leeyunseokarchive/VIVA-Hardware-Enabled-AI-Tutor/VivaMVP/viva-merged/docs/superpowers/plans/2026-08-10-app-split.md

# 앱 분리 (폰 단독판 / 디바이스 연동판) Implementation Plan

> **For agentic workers:** REQUIRED SUB-SKILL: Use superpowers:subagent-driven-development (recommended) or superpowers:executing-plans to implement this plan task-by-task. Steps use checkbox (`- [ ]`) syntax for tracking.

**Goal:** 하나의 앱(런타임 모드 토글)을 두 개의 스마트폰 앱 — 폰 단독 체험판 / 디바이스(라즈베리파이) 연동판 — 으로 분리한다. 한 저장소, 공용 코어 + 앱 셸 2개.

**Architecture:** 3단계. (1) 공용 코드가 디바이스 모듈을 정적 import 하는 곳을 주입으로 뒤집고 디바이스 배타 파일을 `src/device/` 로 이동. (2) `App.tsx`·`HomeScreen`·`ConversationScreen` 을 변종 2벌로 가르고 `mode` 개념 소멸, babel module-resolver alias 로 `APP_VARIANT` 별 엔트리 선택(transform 시점 그래프 절단). (3) `app.config.js` + prebuild 전환으로 빌드 갈래(이름·bundleId·권한 분기).

**Tech Stack:** Expo SDK 57 / RN 0.74 (legacy root), jest-expo + react-test-renderer, babel-plugin-module-resolver (신규 devDep 1개).

**Spec:** `docs/superpowers/specs/2026-08-10-app-split-design.md`. 스펙 대비 정정 2건 (실측 근거):
1. **EyeAnimation·MicLevelIndicator 는 `src/phone/` 으로 이동하지 않는다.** 공용 화면 4개(BoardView·CharacterView·ProcessingView·CameraScreen)가 EyeAnimation 을 정적 import 한다 — 이동하면 공용→phone 의존이 생긴다. 번들 포함은 디렉터리가 아니라 import 그래프가 결정하므로 제자리에 둬도 폰 번들 절단 목표(piBridge 부재)와 무관하다. 대가: 디바이스 번들에 EyeAnimation 죽은 코드 ~수백 줄이 남는다(렌더 경로 없음, `showEyes=false` 상수). 진짜 제거하려면 공용 화면 4개에 눈 컴포넌트 주입이 필요 — 범위 밖.
2. **"공용 코드에 src/device import 0건" 판정은 1단계가 아니라 2단계 종료 시점.** 1단계에서는 App.tsx·HomeScreen·ConversationScreen 이 아직 안 갈라져 디바이스 모듈을 import 한다.

## Global Constraints

- **워크트리 격리 필수.** 메인 체크아웃엔 병렬 세션의 미커밋 `src/screens/HomeScreen.tsx` 변경("헤이, 비바" 문구)이 있다. `git worktree add <path> HEAD` 로 만든 워크트리에서 작업한다 (origin/main 은 로컬보다 25커밋 뒤 — 기본 fresh 워크트리 금지). **`git add -A` 금지, 항상 파일 명시 add.**
- 병합 시점 주의: 이 계획은 구 `HomeScreen.tsx` 를 삭제한다. 병렬 세션이 그 파일의 문구 변경을 커밋하면 병합 충돌 — 해소는 "문구 변경을 `src/device/screens/HomeScreen.tsx` 변종에 재적용"이다.
- bundleId: 디바이스 = `com.vivamvp.app` (기존 유지, 실기기 설치본), 폰 = `com.vivamvp.phone`.
- `APP_VARIANT` 미지정 기본값 = `device` (현행 워크플로·실기기와 동일하게).
- 테스트: `npm test` (jest-expo). 타입: `npx tsc --noEmit`. 린트: `npm run lint`.
- 커밋 접두는 저장소 관례(`feat:`/`fix:`/`refactor:`/`docs:`/`test:`), 한국어 제목. 트레일러: `Co-Authored-By: Claude Fable 5 <noreply@anthropic.com>`.
- 세션 페이로드·기록 포맷(`photoSource` 필드 포함) 불변.
- 마지막에 `docs/process.md` 갱신 (AGENTS.md 규칙).

## 파일 구조 (완료 시점)

```
viva-merged/
  App.phone.tsx            폰 셸 (Task 7)
  App.device.tsx           디바이스 셸 (Task 7)
  index.js                 import App from '@app' (babel alias, Task 7)
  babel.config.js          APP_VARIANT → alias 분기 (Task 7)
  app.config.js            app.json 대체 (Task 9)
  src/
    device/                Task 4에서 이동 + Task 6에서 변종 화면 추가
      services/  piBridge, connectionMonitor, eyeSync, piWakeStream (+ __tests__)
      hooks/     usePiConnection (+ __tests__)
      components/ DeviceVitals, ConnectionGuideCard, ConnectionStatusChip,
                  DisconnectOverlay (+ __tests__)
      screens/   HomeScreen.tsx, ConversationScreen.tsx (+ __tests__)
    phone/
      screens/   HomeScreen.tsx, ConversationScreen.tsx (+ __tests__)
    components/ hooks/ services/ screens/ …  공용 (EyeAnimation·MicLevelIndicator 포함)
  (삭제: App.tsx, src/screens/HomeScreen.tsx, src/screens/ConversationScreen.tsx,
   src/components/ModeToggle.tsx, src/hooks/useAppMode.ts, app.json,
   android/, ios/ (Task 10 gate 통과 시))
```

---

## 1단계: 의존성 뒤집기 + 배타 파일 이동

### Task 1: useAppState — eyeSync 직접 호출을 콜백 주입으로

**Files:**
- Modify: `src/hooks/useAppState.ts`
- Modify: `src/services/eyeSync.service.ts` (STATUS_EYE_STATE 이사)
- Modify: `App.tsx:87-95` (콜백 배선)
- Test: `src/hooks/__tests__/useAppState.test.ts`

**Interfaces:**
- Consumes: 없음 (첫 태스크)
- Produces: `useAppState(options?: { onStatusChange?: (status: AppStatus) => void })` — 시그니처 하위호환(옵션 없이 호출 가능). `eyeSync.service.ts` 가 `export const STATUS_EYE_STATE: Record<AppStatus, EyeState>` 를 새로 export. Task 7 의 App.device.tsx 가 이 둘을 조합해 배선한다.

- [ ] **Step 1: 실패하는 테스트 추가**

`src/hooks/__tests__/useAppState.test.ts` 에 추가 (기존 테스트가 eyeSync 를 mock 하고 있으면 그 mock 은 제거 — 이 태스크가 의존 자체를 없앤다):

```ts
it('전이마다 onStatusChange 콜백을 새 status 로 부른다', () => {
  const onStatusChange = jest.fn();
  const { result } = renderHook(() => useAppState({ onStatusChange }));
  act(() => result.current.startCapturing());
  expect(onStatusChange).toHaveBeenLastCalledWith('capturing');
  act(() => result.current.resetToIdle());
  expect(onStatusChange).toHaveBeenLastCalledWith('idle');
});

it('옵션 없이 호출해도 전이가 동작한다 (폰 셸 경로)', () => {
  const { result } = renderHook(() => useAppState());
  act(() => result.current.startProcessing());
  expect(result.current.appState.status).toBe('processing');
});
```

- [ ] **Step 2: 실패 확인** — `npm test -- useAppState` → FAIL (options 파라미터 없음)

- [ ] **Step 3: 구현**

`src/hooks/useAppState.ts`:
- `import { eyeSyncService } ...` 와 `import type { EyeState } ...`, `STATUS_EYE_STATE` 상수(19-26행) 삭제. 상수와 그 주석 블록(11-18행)은 eyeSync.service.ts 로 그대로 이사.
- 시그니처·콜백:

```ts
export interface UseAppStateOptions {
  /** 상태 전이마다 새 status 로 호출된다. 디바이스 셸이 Pi 눈 미러링
   * (eyeSyncService.sendEyeState(STATUS_EYE_STATE[status]))을 등록한다.
   * 폰 셸은 안 넘긴다 - 미러링 대상이 없다. */
  onStatusChange?: (status: AppStatus) => void;
}

export function useAppState(options?: UseAppStateOptions): UseAppStateResult {
  const [appState, setAppState] = useState<AppState>(initialAppState);
  const previousStatusRef = useRef<AppStatus>(initialAppState.status);
  // 렌더마다 갱신 - transitionTo([]) 가 stale 콜백을 부르지 않게.
  const onStatusChangeRef = useRef(options?.onStatusChange);
  onStatusChangeRef.current = options?.onStatusChange;

  const transitionTo = useCallback((next: AppState) => {
    setAppState(() => {
      console.log(`[AppState] ${previousStatusRef.current} -> ${next.status}`);
      previousStatusRef.current = next.status;
      onStatusChangeRef.current?.(next.status);
      return next;
    });
  }, []);
  // ... 이하 동일
```

`src/services/eyeSync.service.ts` 에 추가:

```ts
import type { AppStatus } from '../types/AppState';
// (STATUS_EYE_STATE 주석 블록을 useAppState.ts 에서 그대로 가져온다)
export const STATUS_EYE_STATE: Record<AppStatus, EyeState> = {
  idle: 'idle',
  capturing: 'idle',
  processing: 'listening',
  conversation: 'conversation',
  history: 'idle',
  session_detail: 'idle',
};
```

`App.tsx` AppContent 시작부(87행):

```ts
import { CALLING_HOLD_MS, eyeSyncService, STATUS_EYE_STATE } from './src/services/eyeSync.service';
// ...
const {
  appState, startCapturing, startProcessing, enterConversation,
  resetToIdle, enterHistory, viewSessionDetail,
} = useAppState({
  onStatusChange: useCallback(
    (status) => eyeSyncService.sendEyeState(STATUS_EYE_STATE[status]),
    [],
  ),
});
```

- [ ] **Step 4: 통과 확인** — `npm test -- useAppState` PASS, 이어서 `npm test` 전체 + `npx tsc --noEmit`. `grep -n "eyeSync" src/hooks/useAppState.ts` → 0건.

- [ ] **Step 5: 커밋** — `git add src/hooks/useAppState.ts src/services/eyeSync.service.ts App.tsx src/hooks/__tests__/useAppState.test.ts` → `refactor: useAppState 의 눈 미러링을 콜백 주입으로 뒤집기`

### Task 2: tts.service — robotSpeaker 플래그를 AudioSink 주입으로

**Files:**
- Modify: `src/services/tts.service.ts`
- Modify: `src/screens/ConversationScreen.tsx:28,108-111` (setRobotSpeaker → setAudioSink)
- Test: `src/services/__tests__/tts.service.test.ts` (robot 케이스 전환)

**Interfaces:**
- Produces:

```ts
export interface AudioSink {
  /** base64 mp3 재생. 재생 완료(또는 중단)까지 resolve 보류. throw 하면
   * speak() 이 폰 스피커로 폴백한다 - 폴백을 원치 않는 셸은 sink 안에서
   * 삼키고 resolve 한다 (디바이스 연동판 정책). */
  play: (base64Mp3: string) => Promise<void>;
  stop: () => Promise<void>;
}
export function setAudioSink(sink: AudioSink | null): void;
```

`setRobotSpeaker` 는 삭제 (호출부는 ConversationScreen 한 곳 + 테스트).

- [ ] **Step 1: 실패하는 테스트** — `tts.service.test.ts` 의 `setRobotSpeaker` 케이스(83-91행 부근)를 다음으로 교체:

```ts
it('AudioSink 가 등록되면 폰 재생 대신 sink.play 로 간다', async () => {
  const play = jest.fn().mockResolvedValue(undefined);
  setAudioSink({ play, stop: jest.fn().mockResolvedValue(undefined) });
  await speak('안녕');
  expect(play).toHaveBeenCalledTimes(1);
  // 폰 경로(파일 쓰기/Sound 로드)는 안 탄다 - 기존 robot 케이스의 단언 유지
  setAudioSink(null);
});

it('sink.play 가 throw 하면 폰 스피커로 폴백한다', async () => {
  setAudioSink({ play: jest.fn().mockRejectedValue(new Error('pi down')), stop: jest.fn() });
  await speak('안녕');
  // 기존 "robotSpeaker 폴백" 케이스의 폰 재생 단언을 그대로 재사용
  setAudioSink(null);
});

it('stopSpeaking 은 등록된 sink.stop 을 부른다', async () => {
  const stop = jest.fn().mockResolvedValue(undefined);
  setAudioSink({ play: jest.fn().mockResolvedValue(undefined), stop });
  await stopSpeaking();
  expect(stop).toHaveBeenCalled();
  setAudioSink(null);
});
```

(기존 robot 테스트의 mock 구조를 최대한 재사용 — 단언 대상만 piBridge mock → sink spy 로 바뀐다. `jest.mock('.../piBridge.service')` 가 tts 테스트에 있으면 제거.)

- [ ] **Step 2: 실패 확인** — `npm test -- tts.service` → FAIL (`setAudioSink` 없음)

- [ ] **Step 3: 구현** — `tts.service.ts`:
- 24행 `import { playAudioOnPi, stopPiPlayback } from './piBridge.service';` 삭제.
- 66-74행 (`robotSpeaker` 변수 + `setRobotSpeaker`) 을 위 Interfaces 의 `AudioSink`/`setAudioSink` 로 교체 (`let audioSink: AudioSink | null = null;`). 기존 로봇 스피커 라우팅 주석은 sink 용어로 고쳐 유지.
- `stopSpeaking()` (246-251행): `if (robotSpeaker) { stopPiPlayback().catch(...) }` → `if (audioSink) { audioSink.stop().catch(() => {}); }`
- `speak()` (310-324행): `if (robotSpeaker)` → `if (audioSink)`, `await playAudioOnPi(base64Mp3)` → `await audioSink.play(base64Mp3)`. 폴백 catch 로직·onPlay(0)·주석 유지.

`ConversationScreen.tsx`:
- 28행 import: `setRobotSpeaker` → `setAudioSink`, type `AudioSink` 추가.
- 108-111행:

```ts
useEffect(() => {
  setAudioSink(robotMode ? { play: playAudioOnPi, stop: stopPiPlayback } : null);
  return () => setAudioSink(null);
}, [robotMode]);
```

(`playAudioOnPi`, `stopPiPlayback` 는 이미 이 파일이 piBridge 에서 import 중 — `playAudioOnPi` 만 import 목록에 추가.)

- [ ] **Step 4: 통과 확인** — `npm test` 전체 + `npx tsc --noEmit`. `grep -n "piBridge" src/services/tts.service.ts` → 0건.

- [ ] **Step 5: 커밋** — `refactor: tts 로봇 스피커 플래그를 AudioSink 주입으로 뒤집기`

### Task 3: useVoiceInput — robotMic 불리언을 RobotMicAdapter 주입으로

**Files:**
- Modify: `src/hooks/useVoiceInput.ts`
- Modify: `src/screens/ConversationScreen.tsx:317-330` (adapter 전달)
- Test: `src/hooks/__tests__/useVoiceInput.test.ts` (robotMic 케이스 전환)

**Interfaces:**
- Produces:

```ts
export interface RobotMicStatus {
  recording: boolean;
  silent_ms?: number;
  had_speech: boolean;
}
export interface RobotMicAdapter {
  /** 녹음 시작. throw 시 폰 마이크 폴백 여부는 allowPhoneMicFallback 이 결정. */
  startRecording: () => Promise<void>;
  stopRecording: () => Promise<void>;
  fetchStatus: () => Promise<RobotMicStatus>;
  /** 발화 전체 WAV base64. */
  fetchAudio: () => Promise<string>;
}
```

옵션 변경: `robotMic?: boolean` → `robotMic?: RobotMicAdapter | null`. 신규 옵션 `allowPhoneMicFallback?: boolean` (기본 `true`; `false` 면 로봇 마이크 시작 실패 시 폰 마이크 대신 `text_fallback` — 디바이스 연동판의 "음성 폰 폴백 없음" 정책, Task 6 이 사용).

- [ ] **Step 1: 실패하는 테스트** — `useVoiceInput.test.ts` 의 robotMic 케이스(73-96행 부근의 mock 포함)를 어댑터 주입으로 전환. piBridge `jest.mock` 을 제거하고:

```ts
const makeAdapter = (overrides = {}) => ({
  startRecording: jest.fn().mockResolvedValue(undefined),
  stopRecording: jest.fn().mockResolvedValue(undefined),
  fetchStatus: jest.fn().mockResolvedValue({ recording: true, silent_ms: 0, had_speech: false }),
  fetchAudio: jest.fn().mockResolvedValue('d2F2'),
  ...overrides,
});

it('로봇 어댑터가 있으면 폰 스트림 대신 어댑터로 녹음을 시작한다', async () => {
  const adapter = makeAdapter();
  const { result } = renderHook(() =>
    useVoiceInput({ onResult: jest.fn(), robotMic: adapter, audioStreamModule: fakeStream }));
  await act(() => result.current.startListening());
  expect(adapter.startRecording).toHaveBeenCalled();
  expect(fakeStream.start).not.toHaveBeenCalled();
});

it('어댑터 시작 실패 + allowPhoneMicFallback:false 면 text_fallback 으로 간다', async () => {
  const adapter = makeAdapter({ startRecording: jest.fn().mockRejectedValue(new Error('EBUSY')) });
  const { result } = renderHook(() =>
    useVoiceInput({ onResult: jest.fn(), robotMic: adapter, allowPhoneMicFallback: false,
      audioStreamModule: fakeStream }));
  await act(() => result.current.startListening());
  expect(result.current.mode).toBe('text_fallback');
  expect(fakeStream.start).not.toHaveBeenCalled();
});

it('어댑터 시작 실패 + 기본값이면 폰 마이크로 폴백한다', async () => {
  const adapter = makeAdapter({ startRecording: jest.fn().mockRejectedValue(new Error('EBUSY')) });
  // 기존 "Pi 시작 실패 → 폰 폴백" 케이스의 단언 재사용 (fakeStream.start 호출됨)
});
```

기존 robot 폴링/종료 테스트(status 폴링 → finalize → fetchAudio → 전사)는 mock 대상만 어댑터 spy 로 바꿔 유지한다.

- [ ] **Step 2: 실패 확인** — `npm test -- useVoiceInput` → FAIL

- [ ] **Step 3: 구현** — `useVoiceInput.ts`:
- 31-36행 piBridge import 삭제, Interfaces 의 타입 2개 추가.
- 옵션: `robotMic = null`, `allowPhoneMicFallback = true`. `robotMicRef` 는 어댑터를 든다: `const robotMicRef = useRef(robotMic); robotMicRef.current = robotMic;`
- `startRobotListening`: `await startPiRecording()` → `await adapter.startRecording()` (어댑터는 호출 시점 `robotMicRef.current`), 폴링 루프의 `fetchPiRecordStatus()` → `adapter.fetchStatus()`.
- `finalizeRobotResult`: `fetchPiAudioBase64()` → `adapter.fetchAudio()`.
- 언마운트 effect(383-386행)·`stopListening`(521-524행): `if (robotMicRef.current) { stopPiRecording().catch(...) }` → `robotMicRef.current?.stopRecording().catch(() => {});`
- `startListening`(407-410행):

```ts
if (robotMicRef.current) {
  const robotStarted = await startRobotListening();
  if (robotStarted) return;
  if (!allowPhoneMicFallback) {
    // 디바이스 연동판: 마이크는 파이 전용 - 폰 마이크로 조용히 잇지 않는다.
    setMode('text_fallback');
    return;
  }
}
```

(`allowPhoneMicFallback` 도 ref 미러 — 다른 옵션과 같은 패턴.)

`ConversationScreen.tsx` 317-330행:

```ts
const robotMicAdapter = useMemo<RobotMicAdapter | null>(
  () =>
    robotMode
      ? {
          startRecording: startPiRecording,
          stopRecording: stopPiRecording,
          fetchStatus: fetchPiRecordStatus,
          fetchAudio: fetchPiAudioBase64,
        }
      : null,
  [robotMode],
);
const voice = useVoiceInput({
  onResult: handleVoiceResult,
  robotMic: robotMicAdapter,
  getTranscribeContext: ...,  // 기존 그대로
});
```

(`fetchPiRecordStatus` 의 반환 타입이 `RobotMicStatus` 와 구조적으로 맞는지 확인 — 안 맞으면 어댑터 안에서 매핑.)

- [ ] **Step 4: 통과 확인** — `npm test` 전체 + `npx tsc --noEmit`. `grep -n "piBridge" src/hooks/useVoiceInput.ts` → 0건.

- [ ] **Step 5: 커밋** — `refactor: useVoiceInput 로봇 마이크를 어댑터 주입으로 뒤집기`

### Task 4: 디바이스 배타 파일 `src/device/` 이동 + PiWakeStream 포트 타입 이사

**Files:**
- Move (`git mv`, 테스트 동반):
  - `src/services/{piBridge,connectionMonitor,eyeSync,piWakeStream}.service.ts` → `src/device/services/`
  - `src/services/__tests__/{piBridge.health,connectionMonitor.service,eyeSync.service,eyeSync.suppress,piWakeStream.service}.test.ts` → `src/device/services/__tests__/`
  - `src/hooks/usePiConnection.ts` → `src/device/hooks/`, `src/hooks/__tests__/usePiConnection.test.ts` → `src/device/hooks/__tests__/`
  - `src/components/{DeviceVitals,ConnectionGuideCard,ConnectionStatusChip,DisconnectOverlay}.tsx` → `src/device/components/`, 대응 `__tests__` 4개 동반
- Modify: `src/hooks/useWakeWord.ts` (PiWakeStream 인터페이스를 여기로 이사 — 포트는 소비자가 정의), `src/device/services/piWakeStream.service.ts` (타입 import 방향 반전), 이동 파일들의 상대 경로, importer 경로: `App.tsx`, `src/screens/HomeScreen.tsx`, `src/screens/ConversationScreen.tsx`, `src/components/ModeToggle.tsx`(연기 — useAppMode 타입만 쓰므로 무변경), `tools/e2e-loop/runner.e2e.ts`, `tools/e2e-loop/driveSession.ts`

**Interfaces:**
- Consumes: Task 1-3 의 주입 전환 (이동 대상들이 더 이상 공용 코드에서 역참조되지 않는 상태… 화면·App 제외)
- Produces: `useWakeWord.ts` 가 `export interface PiWakeStream` 의 새 소유자. 기존 시그니처 그대로 옮기고, `piWakeStream.service.ts`·`App.tsx` 는 `import type { PiWakeStream } from '../../hooks/useWakeWord'`(각자 상대 경로) 로 바꾼다. 그 외 모든 모듈의 export 시그니처 불변 — 경로만 바뀐다.

- [ ] **Step 1: git mv 로 이동** — 위 목록 그대로. 예: `git mv src/services/piBridge.service.ts src/device/services/piBridge.service.ts`
- [ ] **Step 2: 이동 파일 내부의 상대 경로 수정** — 같이 이동한 모듈끼리는 상대 경로 불변(`./piBridge.service`, `../services/connectionMonitor.service` 등 디렉터리 구조가 평행이라 그대로 맞다). 공용을 가리키던 것만 한 단계 추가: eyeSync 의 `../components/EyeAnimation` → `../../components/EyeAnimation`, `../types/AppState` → `../../types/AppState`, DisconnectOverlay·칩 등의 `../theme` → `../../theme` 류. 테스트 파일의 mock 경로(`jest.mock('../../services/...')`)도 같이.
- [ ] **Step 3: PiWakeStream 포트 이사** — `piWakeStream.service.ts` 의 `PiWakeStream`(+ 콜백 타입) 인터페이스 선언을 `src/hooks/useWakeWord.ts` 로 옮기고 export. piWakeStream.service 는 `import type { PiWakeStream } from '../../hooks/useWakeWord';` 로 구현 선언 유지. `App.tsx:32` 의 타입 import 도 `./src/hooks/useWakeWord` 로.
- [ ] **Step 4: importer 경로 갱신** — `App.tsx`(piBridge·connectionMonitor·piWakeStream·eyeSync·usePiConnection → `./src/device/...`), `src/screens/ConversationScreen.tsx`·`src/screens/HomeScreen.tsx`(`../device/...`), `tools/e2e-loop/runner.e2e.ts`·`driveSession.ts`(`../../src/device/services/piBridge.service`).
- [ ] **Step 5: 전체 검증** — `npx tsc --noEmit` → 잔여 경로 오류 0. `npm test` 전체 PASS. `npm run lint` PASS.
- [ ] **Step 6: 커밋** — 이동·수정 파일 명시 add → `refactor: 디바이스 배타 모듈을 src/device/ 로 이동`

---

## 2단계: 셸 가르기

### Task 5: 폰 화면 변종 (`src/phone/screens/`)

**Files:**
- Create: `src/phone/screens/HomeScreen.tsx`, `src/phone/screens/ConversationScreen.tsx`
- Test: `src/phone/screens/__tests__/HomeScreen.test.tsx`, `src/phone/screens/__tests__/ConversationScreen.test.tsx`

**Interfaces:**
- Produces (Task 7 의 App.phone.tsx 가 소비):

```ts
// src/phone/screens/HomeScreen.tsx
interface HomeScreenProps {
  onPressToTalk: () => void;
  onPressHistory: () => void;
  solveMode: boolean;
  onToggleSolveMode: () => void;
}
// src/phone/screens/ConversationScreen.tsx
interface ConversationScreenProps {
  conversation?: ConversationPayload;
  onSessionComplete?: () => void;
  onCameraNeeded?: (question?: string, resume?: ResumeSessionSnapshot) => void;
  solveMode: boolean;
  onToggleSolveMode: () => void;
}
```

- [ ] **Step 1: HomeScreen 변종 작성** — `src/screens/HomeScreen.tsx` 기반, 소멸: `mode`/`onToggleMode`/`piStatus` props, ModeToggle·ConnectionStatusChip·ConnectionGuideCard import 와 렌더, `deviceMode`/`startDisabled` (PTT 는 항상 활성). 중앙은 눈 하나만:

```tsx
<View style={styles.centerArea}>
  <View testID="home-eyes">
    <EyeAnimation state="idle" />
  </View>
</View>
```

경로 주의: `src/phone/screens/` 기준 `../../components/...`, `../../theme`, `../../assets/icons/mic.png`.

- [ ] **Step 2: HomeScreen 테스트** — `src/phone/screens/__tests__/HomeScreen.test.tsx` 신규: 눈 렌더(`home-eyes`), PTT 활성 + onPressToTalk 호출, history 버튼. 구 `src/screens/__tests__/HomeScreen.test.tsx` 의 단언을 이식하되 mode 관련 단언은 버린다.
- [ ] **Step 3: ConversationScreen 변종 작성** — `src/screens/ConversationScreen.tsx` 복사 후 순서대로:
  1. import 삭제: piBridge 전체(30-37행), `DisconnectOverlay`, `AppMode` 타입, `usePiConnection`, `eyeSyncService`.
  2. props: `robotAudio`/`appMode`/`onSwitchToAppMode` 삭제 (위 Interfaces).
  3. `robotMode`(107행)·`setAudioSink` effect(108-111행) 삭제.
  4. `piStatus`/`disconnected`/`disconnectedRef`(113-117행) 삭제. `customSpeak` 의 `if (disconnectedRef.current) return;` 삭제. 끊김 일시정지 effect(336-347행) 삭제. 자동 재청취 가드의 `!disconnected` 조건과 deps 삭제.
  5. `useVoiceInput` 호출에서 `robotMic` 어댑터 삭제 (Task 3 이후의 `robotMicAdapter` useMemo 통째로).
  6. 눈 미러링 effect(622-624행, `eyeSyncService.sendEyeState(eyeState)`) 삭제 — 폰 눈은 `CharacterView state={eyeState}` prop 으로 이미 간다.
  7. `showEyes={appMode === 'app'}` → `showEyes` (BoardView 800행·CharacterView 809행, `showEyes={true}` 의미).
  8. 자막 게이트 919행 `statusSlot.kind === 'subtitle' && !(appMode === 'device' && !requiresBoard)` → `statusSlot.kind === 'subtitle'`.
  9. DisconnectOverlay 블록(951-956행) 삭제.
- [ ] **Step 4: ConversationScreen 테스트** — 구 `src/screens/__tests__/ConversationScreen.test.tsx` 를 복사해 `src/phone/screens/__tests__/` 로. 디바이스 조건부 케이스(`robotAudio`/`appMode="device"`/`disconnected`/`setRobotSpeaker` — 75-150행 부근)를 삭제하고 음성/텍스트 폴백/자막 케이스만 유지, import 경로 갱신.
- [ ] **Step 5: 검증** — `npm test -- phone` PASS + `npx tsc --noEmit`. (구 화면·테스트는 Task 8 까지 공존 — 전체 스위트도 그대로 초록이어야 한다.)
- [ ] **Step 6: 커밋** — `feat: 폰 단독판 화면 변종 (HomeScreen·ConversationScreen)`

### Task 6: 디바이스 화면 변종 + DeviceVitals 배선 + 탈출구 제거

**Files:**
- Create: `src/device/screens/HomeScreen.tsx`, `src/device/screens/ConversationScreen.tsx`
- Modify: `src/device/components/DisconnectOverlay.tsx` (+ 그 테스트) — "휴대폰으로 계속하기" 제거
- Test: `src/device/screens/__tests__/HomeScreen.test.tsx`, `src/device/screens/__tests__/ConversationScreen.test.tsx`

**Interfaces:**
- Consumes: `usePiDeviceHealth(): PiHealth | null` (`src/device/hooks/usePiConnection.ts`), `DeviceVitals` props `{ status: PiConnectionStatus; health: PiHealth | null }`, Task 3 의 `RobotMicAdapter`·`allowPhoneMicFallback`, Task 2 의 `AudioSink`.
- Produces (Task 7 의 App.device.tsx 가 소비):

```ts
// src/device/screens/HomeScreen.tsx
interface HomeScreenProps {
  piStatus: PiConnectionStatus;
  onPressToTalk: () => void;
  onPressHistory: () => void;
  solveMode: boolean;
  onToggleSolveMode: () => void;
}
export const MIC_GRACE_MS = 12000;
export function graceHealth(health: PiHealth | null, connectedSinceMs: number | null, nowMs: number): PiHealth | null;
// src/device/screens/ConversationScreen.tsx — props 는 폰 변종 + robotAudio?: boolean
// DisconnectOverlay — props 가 { onEndSession: () => void } 로 축소
```

- [ ] **Step 1: graceHealth 실패 테스트 먼저** — `src/device/screens/__tests__/HomeScreen.test.tsx`:

```ts
import { graceHealth, MIC_GRACE_MS } from '../HomeScreen';

describe('graceHealth (F1: 연결 엣지 mic_ok 오탐 디바운스)', () => {
  it('연결 직후 grace 안의 micOk:false 는 undefined 로 강등한다', () => {
    const g = graceHealth({ micOk: false, speakerOk: true }, 1000, 1000 + MIC_GRACE_MS - 1);
    expect(g).toEqual({ micOk: undefined, speakerOk: true });
  });
  it('grace 가 지나면 micOk:false 를 그대로 통과시킨다', () => {
    const g = graceHealth({ micOk: false, speakerOk: true }, 1000, 1000 + MIC_GRACE_MS);
    expect(g).toEqual({ micOk: false, speakerOk: true });
  });
  it('micOk:true·null health·미연결(connectedSince null)은 손대지 않는다', () => {
    expect(graceHealth({ micOk: true }, 1000, 1001)).toEqual({ micOk: true });
    expect(graceHealth(null, 1000, 1001)).toBeNull();
    expect(graceHealth({ micOk: false }, null, 1001)).toEqual({ micOk: false });
  });
});
```

- [ ] **Step 2: 실패 확인** → **Step 3: HomeScreen 변종 구현** — 구 HomeScreen 기반. 소멸: `mode`/`onToggleMode`, ModeToggle, EyeAnimation 분기(APP 모드 중앙). 유지: ConnectionStatusChip, 웨이크 가이드/연결 중/가이드 카드 3분기, PTT(`piStatus !== 'connected'` 면 disabled), history, SolveModeToggle. 추가:

```tsx
// F1 (device-vitals 스펙 정정 절): 연결 직후 첫 /health 프로브는 wake 스트림
// resume 전이라 멀쩡한 마이크도 mic_ok:false 로 온다. 연결 엣지에서
// MIC_GRACE_MS 동안 micOk:false 를 "모름"으로 강등해 오탐 주황 점을 막는다.
// 5초 폴링이라 grace 만료 후 늦어도 다음 폴에서 실값이 반영된다.
export const MIC_GRACE_MS = 12000;
export function graceHealth(
  health: PiHealth | null, connectedSinceMs: number | null, nowMs: number,
): PiHealth | null {
  if (!health || health.micOk !== false || connectedSinceMs === null) return health;
  if (nowMs - connectedSinceMs < MIC_GRACE_MS) return { ...health, micOk: undefined };
  return health;
}
```

컴포넌트 안:

```tsx
const health = usePiDeviceHealth();
// state 여야 한다 (ref 금지): 엣지 직후 grace 적용된 값으로 재렌더가 일어나야
// 한다 - ref 면 다음 5초 폴 재렌더까지 주황 점이 그대로 보인다.
const [connectedSince, setConnectedSince] = useState<number | null>(null);
useEffect(() => {
  setConnectedSince(piStatus === 'connected' ? Date.now() : null);
}, [piStatus]);
// ...
<ConnectionStatusChip status={piStatus} safeTop={safeTop} />
<DeviceVitals status={piStatus} health={graceHealth(health, connectedSince, Date.now())} />
```

(DeviceVitals 배치는 칩 줄 나란히 — DeviceVitals 자체 스타일이 이미 그 문법. 칩의 safeTop 오프셋은 ModeToggle 소멸로 `safeTop` 으로 당긴다.)

- [ ] **Step 4: HomeScreen 렌더 테스트** — connected + health `{micOk:true, speakerOk:true}` mock 시 `device-vitals` testID 렌더, disconnected 시 ConnectionGuideCard·PTT disabled. (usePiConnection/usePiDeviceHealth 는 `jest.mock`.)
- [ ] **Step 5: DisconnectOverlay 축소** — `onContinueInAppMode` prop·버튼 제거, "세션 종료"만 유지. 테스트에서 해당 버튼 케이스 삭제.
- [ ] **Step 6: ConversationScreen 변종** — 복사 후:
  1. props: `appMode`/`onSwitchToAppMode` 삭제, `robotAudio` 유지.
  2. `disconnected = piStatus === 'disconnected'` (appMode 조건 삭제).
  3. AudioSink 를 무폴백 sink 로 (스펙 "음성 폰 폴백 없음"):

```ts
useEffect(() => {
  setAudioSink(
    robotMode
      ? {
          // 디바이스 연동판: 스피커는 파이 전용. 재생 실패 시 폰 스피커로
          // 이어가지 않는다 - 삼키고 resolve 하면 speak() 은 폴백 없이 끝나고
          // 자막(onPlay(0) 경로)이 내용을 전달한다.
          play: async (b64) => {
            try { await playAudioOnPi(b64); } catch (err) {
              console.warn('[ConversationScreen] Pi playback failed - staying silent:', err);
            }
          },
          stop: stopPiPlayback,
        }
      : null,
  );
  return () => setAudioSink(null);
}, [robotMode]);
```

  4. `useVoiceInput` 에 `allowPhoneMicFallback: false` 추가 (robotMic 어댑터 유지).
  5. `showEyes={appMode === 'app'}` → `showEyes={false}` (2곳).
  6. 자막 게이트 919행 → `statusSlot.kind === 'subtitle' && requiresBoard`.
  7. DisconnectOverlay 호출부에서 `onContinueInAppMode` 삭제.
- [ ] **Step 7: ConversationScreen 테스트** — 구 테스트의 디바이스 케이스를 복사·이식(끊김 시 오버레이·마이크 정지, robotAudio sink 등록). 신규 단언: 오버레이에 "휴대폰으로 계속" 부재, sink 등록 시 무폴백(play reject 후 폰 재생 mock 미호출).
- [ ] **Step 8: 검증** — `npm test` 전체 PASS + `npx tsc --noEmit`.
- [ ] **Step 9: 커밋** — `feat: 디바이스 연동판 화면 변종 + DeviceVitals 배선(F1 grace) + 앱모드 탈출구 제거`

### Task 7: 앱 셸 2벌 + APP_VARIANT 엔트리 선택

**Files:**
- Create: `App.phone.tsx`, `App.device.tsx`
- Modify: `babel.config.js`, `index.js`, `package.json` (devDep + scripts)

**Interfaces:**
- Consumes: Task 1 `useAppState(options)`, Task 4 의 `src/device/` 경로·`PiWakeStream`(useWakeWord 소유), Task 5·6 화면 변종 props.
- Produces: `@app` alias — `APP_VARIANT=phone` 이면 `./App.phone`, 그 외 `./App.device`.

- [ ] **Step 1: devDep 설치** — `npm i -D babel-plugin-module-resolver`
- [ ] **Step 2: babel.config.js**

```js
module.exports = function (api) {
  // APP_VARIANT 별로 캐시를 가른다 - 안 가르면 변형 전환 후에도 이전 alias 로
  // 변환된 캐시가 남는다. 전환 시 번들러 재시작(-c) 필요한 건 동일.
  api.cache.using(() => process.env.APP_VARIANT);
  const variant = process.env.APP_VARIANT === 'phone' ? 'phone' : 'device';
  return {
    presets: ['babel-preset-expo'],
    plugins: [
      ['module-resolver', { alias: { '@app': `./App.${variant}` } }],
      // 반드시 마지막 (Reanimated 공식 문서 요구사항).
      'react-native-reanimated/plugin',
    ],
  };
};
```

- [ ] **Step 3: App.device.tsx** — 현 `App.tsx` 에서 출발, 소멸 목록:
  - `useAppMode`/`mode`/`setMode`/`toggleMode`/`modeRef` 전부. `useAppState` 는 Task 1 의 콜백 배선 유지.
  - 모드 effect(151-162행) → 마운트 effect 로:

```ts
useEffect(() => {
  connectionMonitor.start();
  return () => connectionMonitor.stop();
}, []);
```

  (`eyeSyncService.setSuppressed` 호출 자체 불필요 — 억제 개념은 APP 모드 전용이었다. `stopPiPlayback`/`stopPiRecording` 정리 분기도 모드 전환이 없으니 소멸.)
  - `wakePiSource`(166-177행): 가드가 연결만 본다 — `if (connectionMonitor.status !== 'connected') throw ...`
  - `beginCapture`: `const usePi = connectionMonitor.status === 'connected';` (안전값 폰 카메라 폴백 경로·pi 실패 catch 의 probeNow 분기 전부 유지 — "촬영만 폰 폴백").
  - 웨이크 effect(338-370행): `mode === 'device'` 분기만 남긴다 (idle 아니면 정지, connected 면 resume→startListening, 아니면 stopListening). `mode` dep 삭제.
  - 렌더: `HomeScreen`(device 변종 — `piStatus`+`onPressToTalk`+`onPressHistory`+solve props), `CameraScreen showEyes={false}`, `ProcessingView showEyes={false}`, `ConversationScreen`(device 변종 — `robotAudio={piStatus === 'connected'}`, appMode/onSwitchToAppMode 없음).
  - import 는 `./src/device/...` 변종 화면·서비스로.
- [ ] **Step 4: App.phone.tsx** — 현 `App.tsx` 에서 출발, 소멸: piWakeStream/connectionMonitor/eyeSync/piBridge/usePiConnection import 전부, `wakePiSource`, 모드 effect, beginCapture 의 pi 경로(`eyeSyncService.sendEyeState('calling')` 포함 — 폰은 미러 대상 없음) → 골자:

```ts
const beginCapture = useCallback(async () => {
  console.log('[App] beginCapture (phone)');
  if (stopListeningRef.current) {
    try { await stopListeningRef.current(); } catch (err) {
      console.warn('[App] wake word teardown failed - continuing to capture:', err);
    }
  }
  resumeSessionRef.current = undefined;
  // 마이크 스트림 해제 대기 (기존 openPhoneCamera 주석·700ms 유지)
  await new Promise<void>((resolve) => setTimeout(resolve, 700));
  startCapturing();
}, [startCapturing]);
const { startListening, stopListening } = useWakeWord(beginCapture);
```

  웨이크 effect 는 `appState.status !== 'idle' ? stopListening() : startListening()` 두 갈래만. `useAppState()` 는 옵션 없이. 렌더: phone 변종 화면들, `showEyes={true}` (CameraScreen·ProcessingView).
  (`useWakeWord` 의 opts 파라미터가 필수면 `useWakeWord(beginCapture, {})` — 구현 확인 후 맞춘다.)
- [ ] **Step 5: index.js** — `import App from './App';` → `import App from '@app';`
- [ ] **Step 6: package.json scripts** — 기존 4개에 APP_VARIANT 명시:

```json
"start": "APP_VARIANT=device expo start",
"start:phone": "APP_VARIANT=phone expo start",
"android": "APP_VARIANT=device expo run:android",
"android:phone": "APP_VARIANT=phone expo run:android",
"ios": "APP_VARIANT=device expo run:ios",
"ios:phone": "APP_VARIANT=phone expo run:ios",
```

- [ ] **Step 7: 검증** — `npx tsc --noEmit` (App.phone/App.device 포함), `npm test` 전체. jest 는 babel.config 를 타므로 alias 존재가 무해한지 확인(테스트는 `@app` 을 import 하지 않는다).
- [ ] **Step 8: 커밋** — `feat: 폰/디바이스 앱 셸 분리 + APP_VARIANT 엔트리 선택`

### Task 8: 구 단일 앱 소멸 + 경계 고정 + 번들 검증

**Files:**
- Delete: `App.tsx`, `src/screens/HomeScreen.tsx`, `src/screens/ConversationScreen.tsx`, `src/components/ModeToggle.tsx`, `src/hooks/useAppMode.ts`
- Delete tests: `src/hooks/__tests__/useAppMode.test.ts`, `src/components/__tests__/HomeScreen.modes.test.tsx`, `src/screens/__tests__/HomeScreen.test.tsx`, `src/screens/__tests__/ConversationScreen.test.tsx`
- Modify: `src/components/__tests__/connectionUi.test.tsx` (ModeToggle describe 블록 삭제, import 경로는 Task 4 에서 이미 device 로), `.eslintrc.js`

**Interfaces:**
- Consumes: Task 5-7 완료 (변종·셸이 구 파일의 유일한 대체재)

- [ ] **Step 1: 참조 잔존 확인** — `grep -rn "screens/HomeScreen\|screens/ConversationScreen\|ModeToggle\|useAppMode" src/ App.*.tsx index.js tools/ --include="*.ts*" | grep -v "phone/screens\|device/screens"` → 삭제 대상 자신들 외 0건이어야 진행.
- [ ] **Step 2: `git rm` 으로 삭제** (위 목록), connectionUi.test 의 ModeToggle 블록 삭제.
- [ ] **Step 3: 경계 고정** — `.eslintrc.js`:

```js
rules: {
  'prettier/prettier': 'warn',
  // 공용·폰 코드가 디바이스 그래프를 물면 폰 번들 절단이 무너진다.
  'no-restricted-imports': ['error', { patterns: [
    { group: ['**/device/**'], message: '디바이스 모듈은 src/device/ 와 App.device.tsx 만 import 할 수 있다.' },
  ]}],
},
overrides: [
  {
    files: ['src/device/**', 'App.device.tsx', 'tools/e2e-loop/**'],
    rules: {
      'no-restricted-imports': ['error', { patterns: [
        { group: ['**/phone/**'], message: '디바이스 그래프는 폰 변종을 import 할 수 없다.' },
      ]}],
    },
  },
  {
    files: ['src/phone/**', 'App.phone.tsx'],
    rules: {
      'no-restricted-imports': ['error', { patterns: [
        { group: ['**/device/**'], message: '폰 그래프는 디바이스 모듈을 import 할 수 없다.' },
      ]}],
    },
  },
],
```

  (기존 `.eslintrc.js` 구조에 맞춰 병합. `npm run lint` 로 실효 확인 — 일부러 위반 import 를 임시로 넣어 에러가 나는지 1회 확인 후 되돌린다.)
- [ ] **Step 4: 전체 검증** — `npm test` PASS, `npx tsc --noEmit`, `npm run lint`.
- [ ] **Step 5: 번들 절단 실증** —

```bash
APP_VARIANT=phone npx expo export --platform android --output-dir /tmp/phone-export
grep -rc "piBridge\|connectionMonitor" /tmp/phone-export/_expo/static/js | sort  # 전부 :0 기대
APP_VARIANT=device npx expo export --platform android --output-dir /tmp/device-export
grep -rlc "piBridge" /tmp/device-export/_expo/static/js  # ≥1 기대 (대조군)
```

  (export 출력 디렉터리 구조가 다르면 js 번들 파일을 찾아 같은 grep. 실패 시 원인 보고 — 넘어가지 않는다.)
- [ ] **Step 6: 커밋** — `refactor: 단일 앱 셸·모드 토글 소멸, 변종 경계 eslint 고정`

---

## 3단계: 빌드 갈래

### Task 9: app.config.js 전환

**Files:**
- Create: `app.config.js`
- Delete: `app.json`

**Interfaces:**
- Consumes: Task 7 의 `APP_VARIANT` 관례.
- Produces: variant 별 `{ name, slug, bundleId/package, 권한 }`. 디바이스 = 현 app.json 과 동일 값 유지.

- [ ] **Step 1: app.config.js 작성** — 현 `app.json`(위 값 그대로) 을 기반으로:

```js
// APP_VARIANT=phone|device (기본 device - 기존 워크플로 유지).
// 폰 단독판은 Pi 로컬넷 관련 권한·예외가 전부 빠진다: NSLocalNetworkUsageDescription,
// NSBonjourServices, viva.local ATS 예외, android usesCleartextTraffic.
const phone = process.env.APP_VARIANT === 'phone';

module.exports = {
  expo: {
    name: phone ? 'VIVA 체험판' : 'VIVA',
    slug: phone ? 'viva-phone' : 'viva-merged',
    version: '1.0.0',
    orientation: 'landscape',
    icon: './assets/icon.png',
    userInterfaceStyle: 'light',
    ios: {
      supportsTablet: true,
      bundleIdentifier: phone ? 'com.vivamvp.phone' : 'com.vivamvp.app',
      ...(phone
        ? {}
        : {
            infoPlist: {
              NSLocalNetworkUsageDescription:
                'VIVA가 로봇 헤드(라즈베리파이)와 같은 와이파이에서 통신하기 위해 로컬 네트워크 접근이 필요합니다.',
              NSBonjourServices: ['_http._tcp'],
              NSAppTransportSecurity: {
                NSExceptionDomains: {
                  'viva.local': {
                    NSExceptionAllowsInsecureHTTPLoads: true,
                    NSIncludesSubdomains: true,
                  },
                },
              },
            },
          }),
    },
    android: {
      package: phone ? 'com.vivamvp.phone' : 'com.vivamvp.app',
      ...(phone ? {} : { usesCleartextTraffic: true }),
      adaptiveIcon: {
        backgroundColor: '#FAF7F0',
        foregroundImage: './assets/android-icon-foreground.png',
        backgroundImage: './assets/android-icon-background.png',
        monochromeImage: './assets/android-icon-monochrome.png',
      },
    },
    web: { favicon: './assets/favicon.png' },
    plugins: [
      ['@react-native-voice/voice', { microphonePermission: 'Allow VIVA to access your microphone for voice tutoring.' }],
      ['react-native-vision-camera', { cameraPermissionText: 'Allow VIVA to access your camera to scan math problems.', enableMicrophonePermission: false }],
      'expo-dev-client',
      ['expo-splash-screen', { image: './assets/splash-icon.png', imageWidth: 200, resizeMode: 'contain', backgroundColor: '#FAF7F0' }],
    ],
  },
};
```

  (앱 이름 'VIVA 체험판' 은 잠정 — 사용자 확정 대상으로 보고에 명시.)
- [ ] **Step 2: app.json 삭제** — `git rm app.json`. `npx expo config --json | head -40` 과 `APP_VARIANT=phone npx expo config --json | head -40` 으로 두 변형의 name/bundleId/권한 분기 확인.
- [ ] **Step 3: 커밋** — `feat: app.config.js 로 전환 - APP_VARIANT 별 이름·bundleId·권한 분기`

### Task 10: prebuild 전환 (게이트 있음)

**Files:**
- Inspect: `android/`, `ios/` (커밋본 vs 재생성본 diff)
- Delete (게이트 통과 시): `android/`, `ios/` + `.gitignore` 에 두 줄 추가

- [ ] **Step 1: 재생성 diff** — 워크트리에서 (모두 커밋된 상태 확인 후):

```bash
npx expo prebuild --platform all --no-install
git status --short   # android/ ios/ 변경 목록
git diff --stat android ios
git diff android ios > /tmp/prebuild.diff   # 검토용
```

- [ ] **Step 2: 게이트 판정** — diff 를 읽고 분류: (a) config·플러그인이 재생성하는 정상 차이(버전 코드, 자동 생성 주석 등) 뿐이면 통과. (b) **수동 네이티브 수정 발견 시 중단** — 해당 수정을 목록화해 보고하고, config plugin 이관은 별도 결정. `patches/` 3개는 node_modules 패치라 무관.
- [ ] **Step 3: (통과 시) 네이티브 삭제** — `git checkout -- android ios && git rm -r android ios`, `.gitignore` 에 `/android`·`/ios` 추가. `npx expo prebuild --platform android` 재실행으로 클린 생성 확인 (빌드까지는 실기기 단계 — 사람 몫으로 기록).
- [ ] **Step 4: 커밋** — `feat: prebuild(CNG) 전환 - 커밋된 네이티브 프로젝트 제거`
- [ ] **Step 5: docs/process.md 갱신** — 앱 분리 완료 기록 (진행 히스토리 + 현재 상태 + 사람 몫: 실기기에서 `npm run android` / `npm run android:phone` 각각 설치·스모크(웨이크→촬영→대화 한 턴), 폰 변형은 로컬넷 권한 프롬프트 부재 확인). 커밋 `docs: 앱 분리 진행 기록`

---

## 테스트 요약 (스펙 대비)

- 소멸: `useAppMode.test.ts`, `HomeScreen.modes.test.tsx`, `connectionUi.test.tsx` ModeToggle 블록, 구 화면 테스트 2개 (Task 8).
- 분리: ConversationScreen 테스트 → 변종별 (Task 5·6). robot 케이스 → 주입 계약 테스트 (Task 2·3).
- 신규: `graceHealth` (F1), DisconnectOverlay 축소, 무폴백 sink/mic, eslint 경계, 번들 grep (Task 6·8).
- 알려진 기존 실패: 메인 체크아웃의 `HomeScreen.modes.test.tsx` 1건은 병렬 세션 미커밋 변경 탓 — 워크트리(HEAD)에선 초록이며, Task 8 에서 파일 자체가 소멸한다.

## 위험

- 병렬 세션 충돌: Global Constraints 참조. 병합 시 구 HomeScreen 삭제 vs 문구 변경 충돌 예상 — 문구를 device 변종에 이식해 해소.
- 셸 가르기 회귀: 변종별 실기기 스모크는 사람 몫 (Task 10 Step 5 에 기록).
- prebuild: Task 10 게이트가 안전판. 게이트 (b) 면 중단하고 보고.

---

## 추가 요구 (2026-08-10 사용자 지시, 실행 중 접수)

### Task 9 수정: 아이콘 분기
폰판 = 기존 로고 유지, 디바이스판 = 로봇 눈 idle 로고 (`assets/icon-device.png` 및
`android-icon-device-{foreground,background,monochrome}.png`, 92c50aa 생성 —
`tools/gen_device_icon.py` 로 재생성 가능). app.config.js 에서 `icon`·`adaptiveIcon` 을
variant 로 분기한다.

### Task 11: DeviceVitals — 상시 표시 → 이상 시에만 배지

**Files:** Modify `src/device/components/DeviceVitals.tsx` (+ 테스트),
`src/device/services/piBridge.service.ts`·`connectionMonitor.service.ts` (`PiHealth` 에
`camOk?`·`displayOk?` 수용), `src/device/screens/HomeScreen.tsx` (배선 불변 확인)

- 표시 규칙: 부품별로 `false` 일 때만 이상 배지 렌더 (마이크 안 들려 / 소리가 안 나와 /
  카메라 안 보여 / 화면이 안 나와). `true`·`undefined` 는 아무것도 안 그린다 —
  connected + 전부 정상이면 컴포넌트가 null (기존 "모름은 비표시" 원칙의 확장).
- 배지 문법: 기존 점+라벨 디자인 유지하되 주황 점 + INK 라벨 (정상 초록 점 소멸).
- `PiHealth` 에 `camOk?: boolean; displayOk?: boolean` 추가 — `optionalBool` 파싱 재사용.
  파이 서버가 아직 안 보내므로 undefined → 미표시 (하위호환).
- 접근성: 이상 있을 때만 컨테이너 accessibilityLabel "비바 상태: 마이크 안 들려" 식으로.
- **파이 서버 카메라·디스플레이 프로브는 범위 밖** — 후속 (실기기 배포 필요).
- graceHealth(F1)는 micOk 강등 로직 그대로 유효.
