leeyunseokarchive/VIVA-Hardware-Enabled-AI-Tutor/VivaMVP/viva-merged/tools/concept-images/img/counting-cases.png

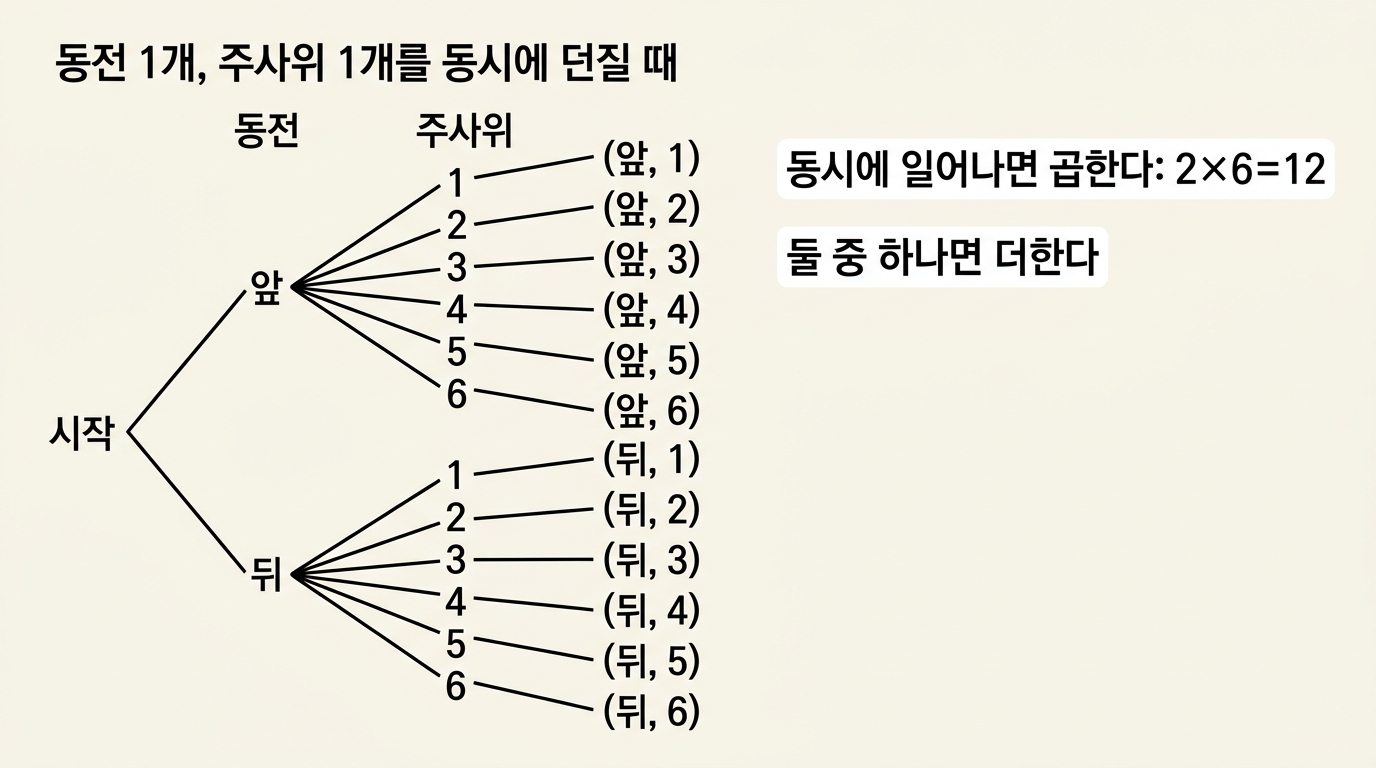
VivaMVP/viva-merged/tools/concept-images/img/counting-cases.png
