leeyunseokarchive/VIVA-Hardware-Enabled-AI-Tutor/VivaMVP/viva-merged/tools/concept-images/img/factorization.png

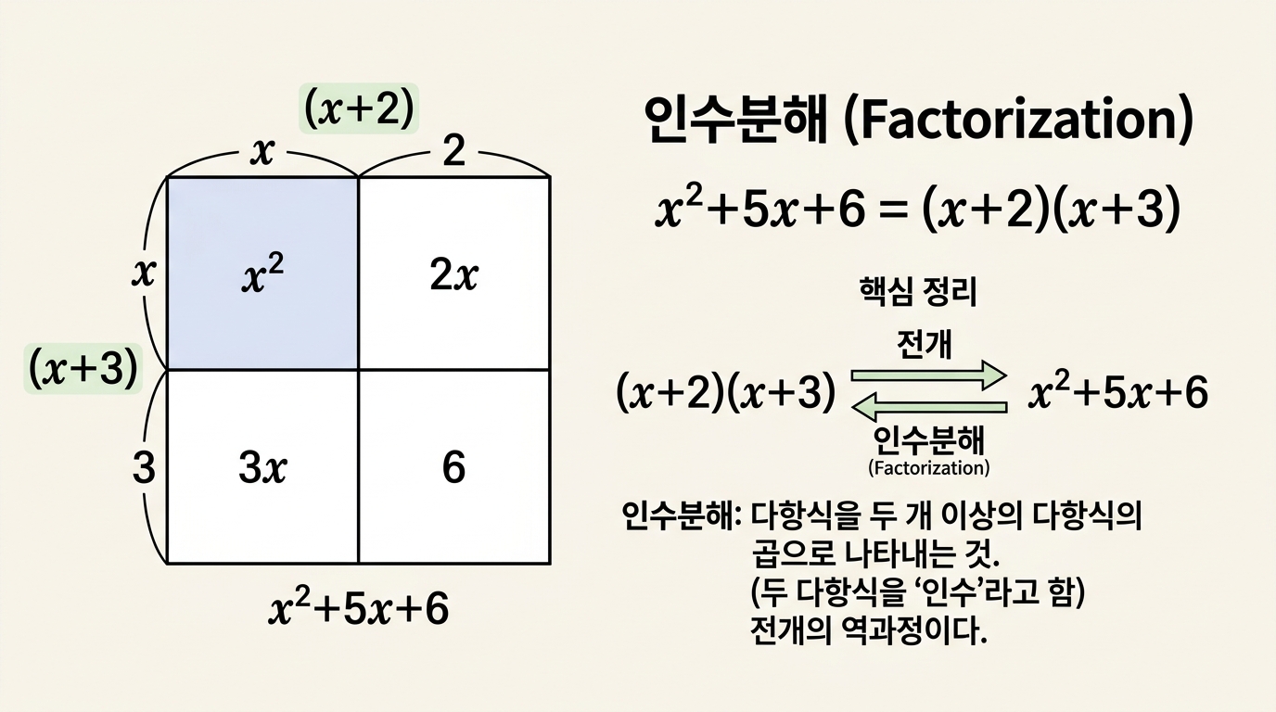
VivaMVP/viva-merged/tools/concept-images/img/factorization.png
