leeyunseokarchive/VIVA-Hardware-Enabled-AI-Tutor/VivaMVP/viva-merged/tools/concept-images/img/function-concept.png

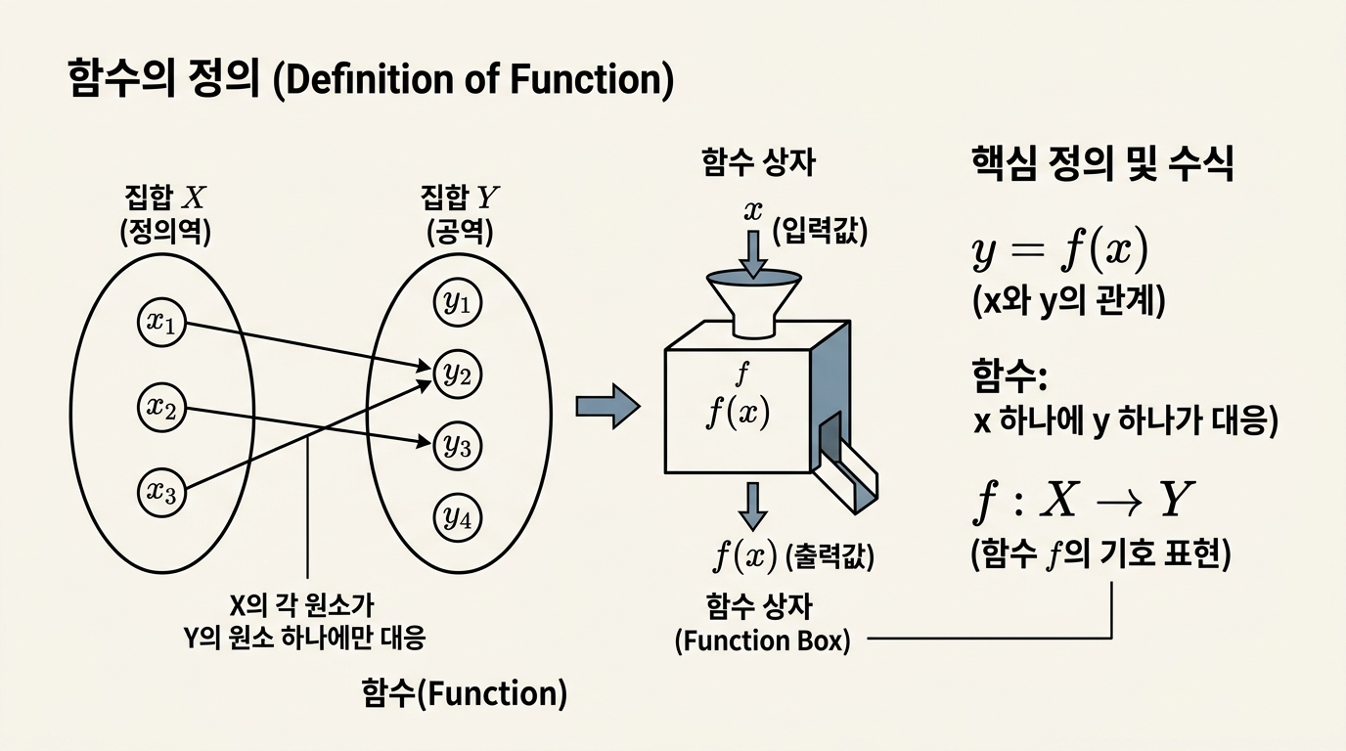
VivaMVP/viva-merged/tools/concept-images/img/function-concept.png
