leeyunseokarchive/VIVA-Hardware-Enabled-AI-Tutor/VivaMVP/viva-merged/tools/concept-images/img/inscribed-angle.png

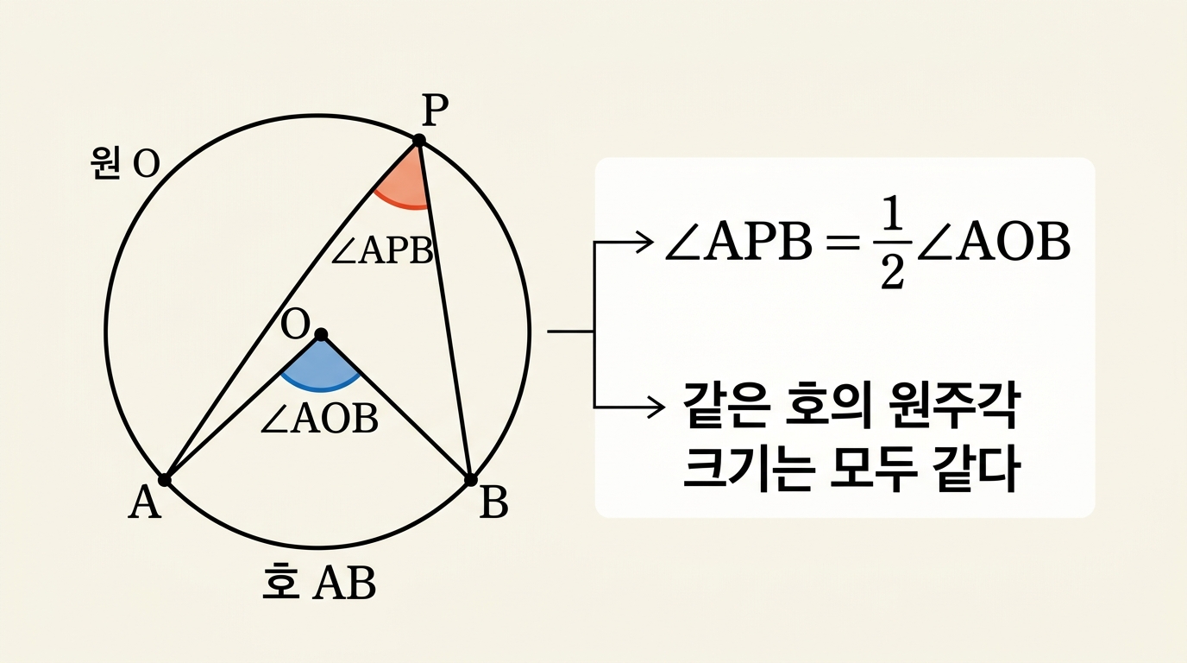
VivaMVP/viva-merged/tools/concept-images/img/inscribed-angle.png
