leeyunseokarchive/VIVA-Hardware-Enabled-AI-Tutor/VivaMVP/viva-merged/tools/concept-images/img/irrational-number.png

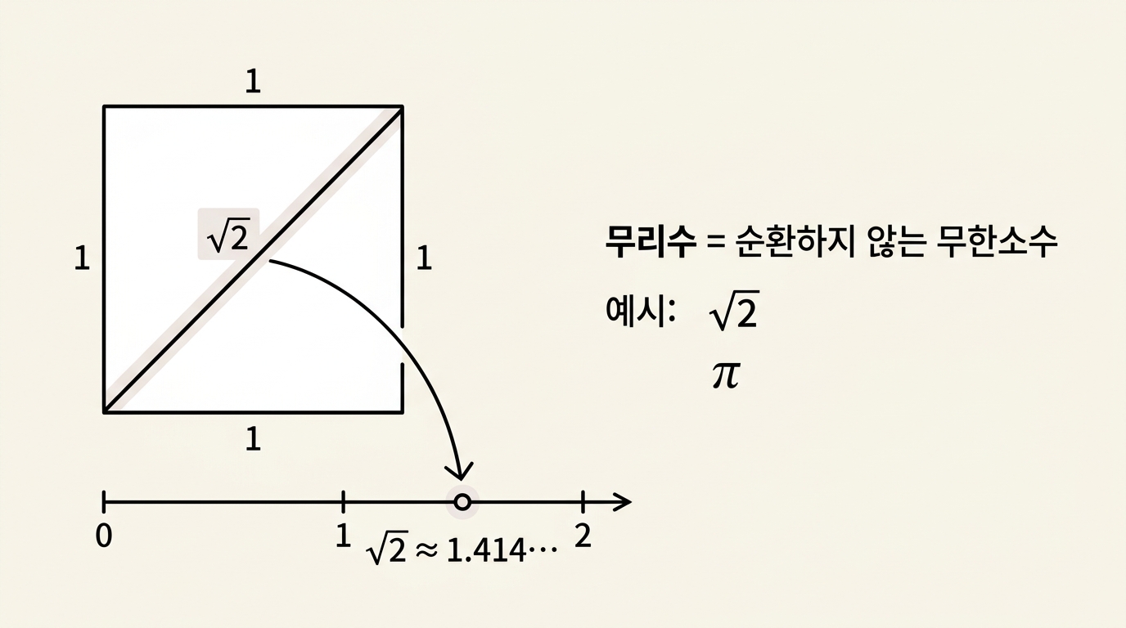
VivaMVP/viva-merged/tools/concept-images/img/irrational-number.png
