leeyunseokarchive/VIVA-Hardware-Enabled-AI-Tutor/VivaMVP/viva-merged/tools/concept-images/img/linear-equation.png

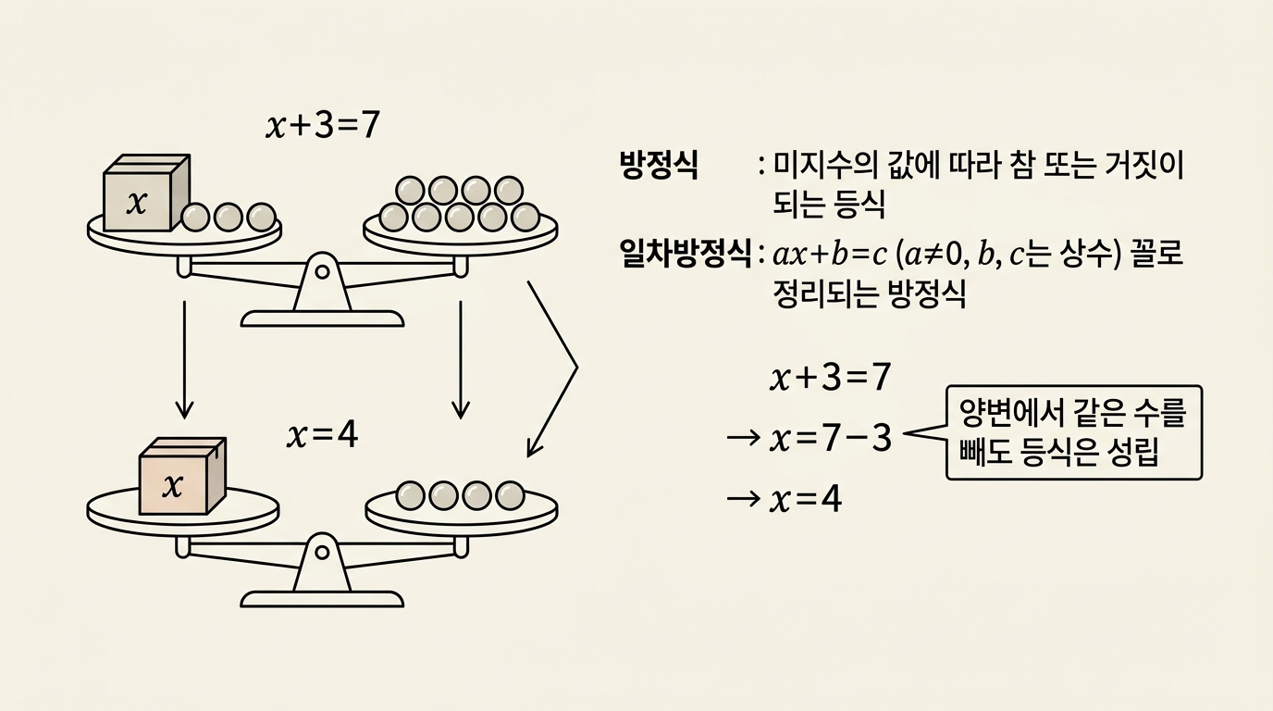
VivaMVP/viva-merged/tools/concept-images/img/linear-equation.png
