leeyunseokarchive/VIVA-Hardware-Enabled-AI-Tutor/VivaMVP/viva-merged/tools/concept-images/img/multiplication-formula.png

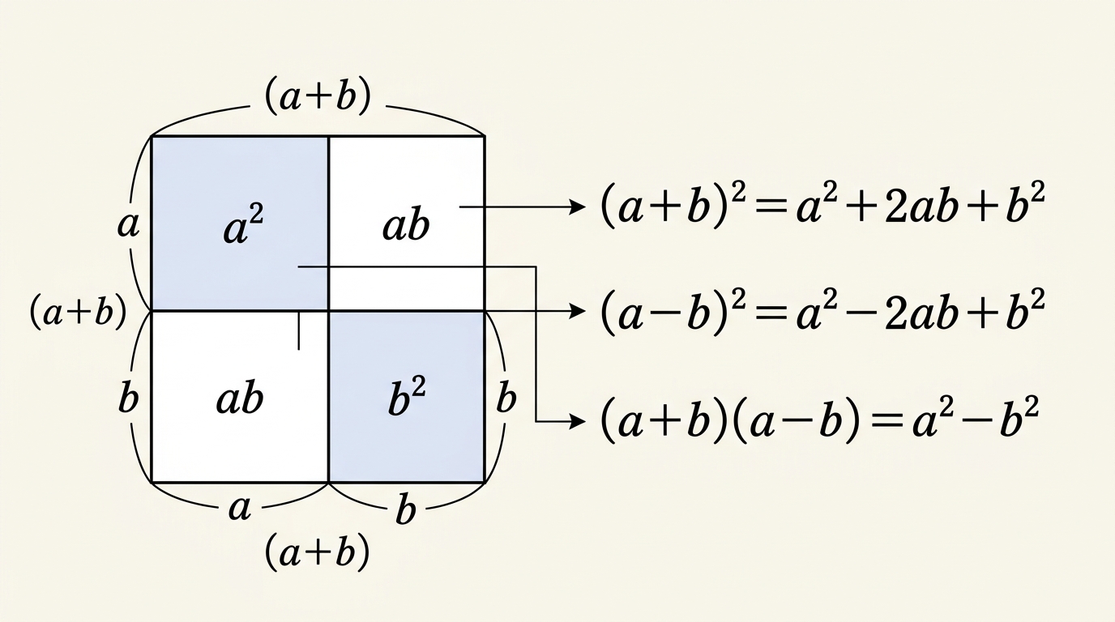
VivaMVP/viva-merged/tools/concept-images/img/multiplication-formula.png
