leeyunseokarchive/VIVA-Hardware-Enabled-AI-Tutor/VivaMVP/viva-merged/tools/concept-images/img/probability.png

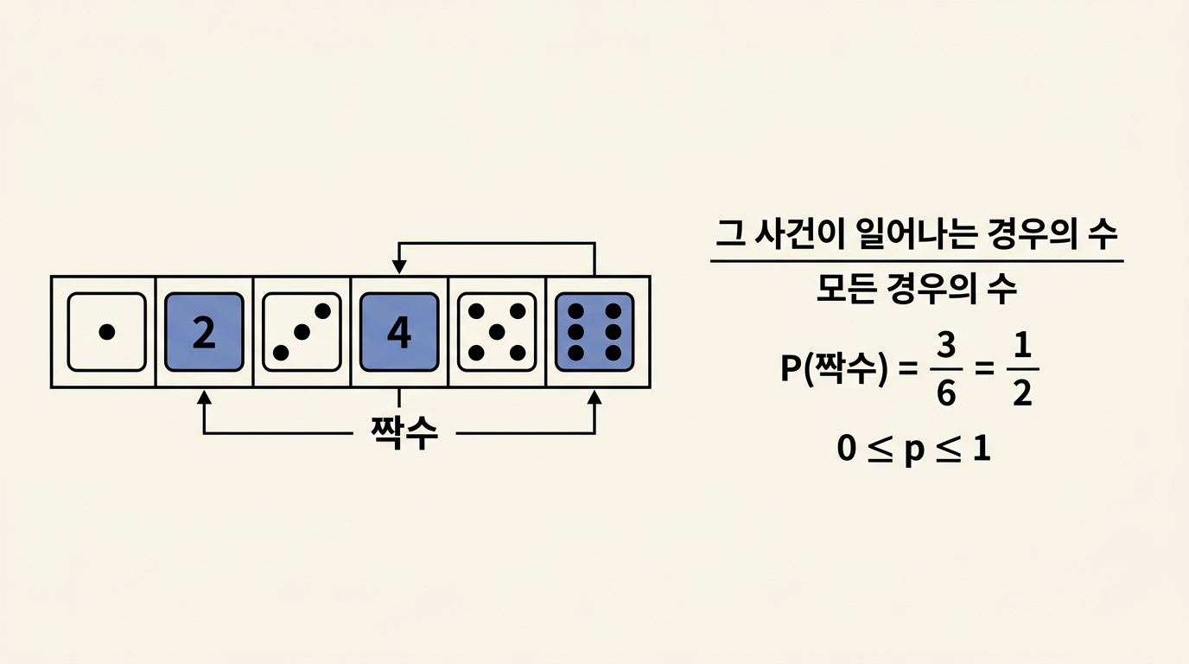
VivaMVP/viva-merged/tools/concept-images/img/probability.png
