leeyunseokarchive/VIVA-Hardware-Enabled-AI-Tutor/VivaMVP/viva-merged/tools/concept-images/img/pythagorean-theorem.png

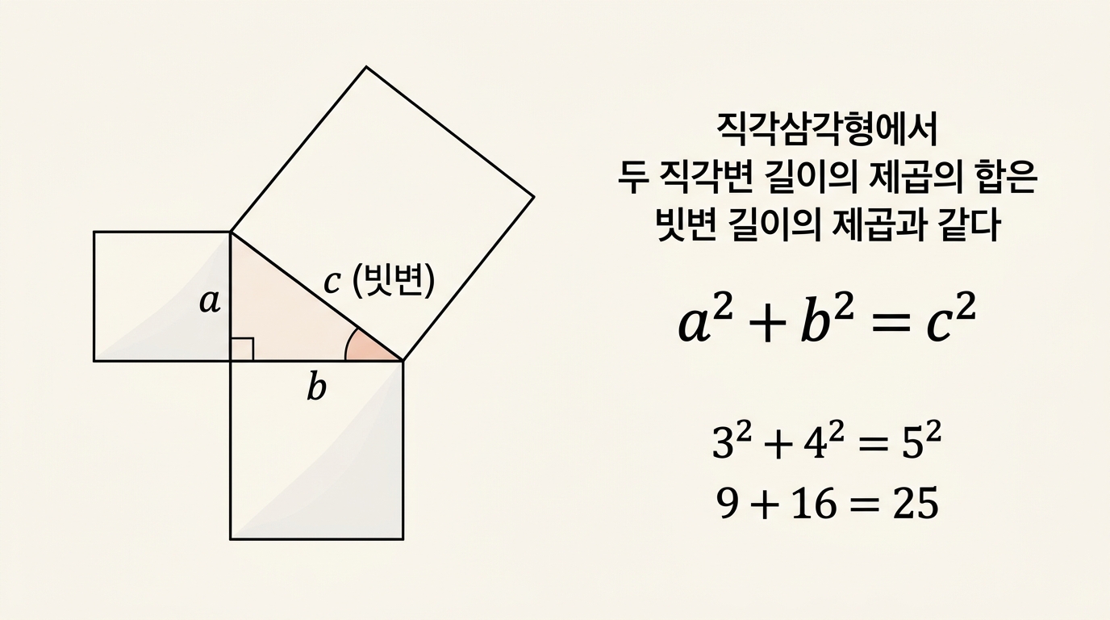
VivaMVP/viva-merged/tools/concept-images/img/pythagorean-theorem.png
