leeyunseokarchive/VIVA-Hardware-Enabled-AI-Tutor/VivaMVP/viva-merged/tools/concept-images/img/quadratic-function.png

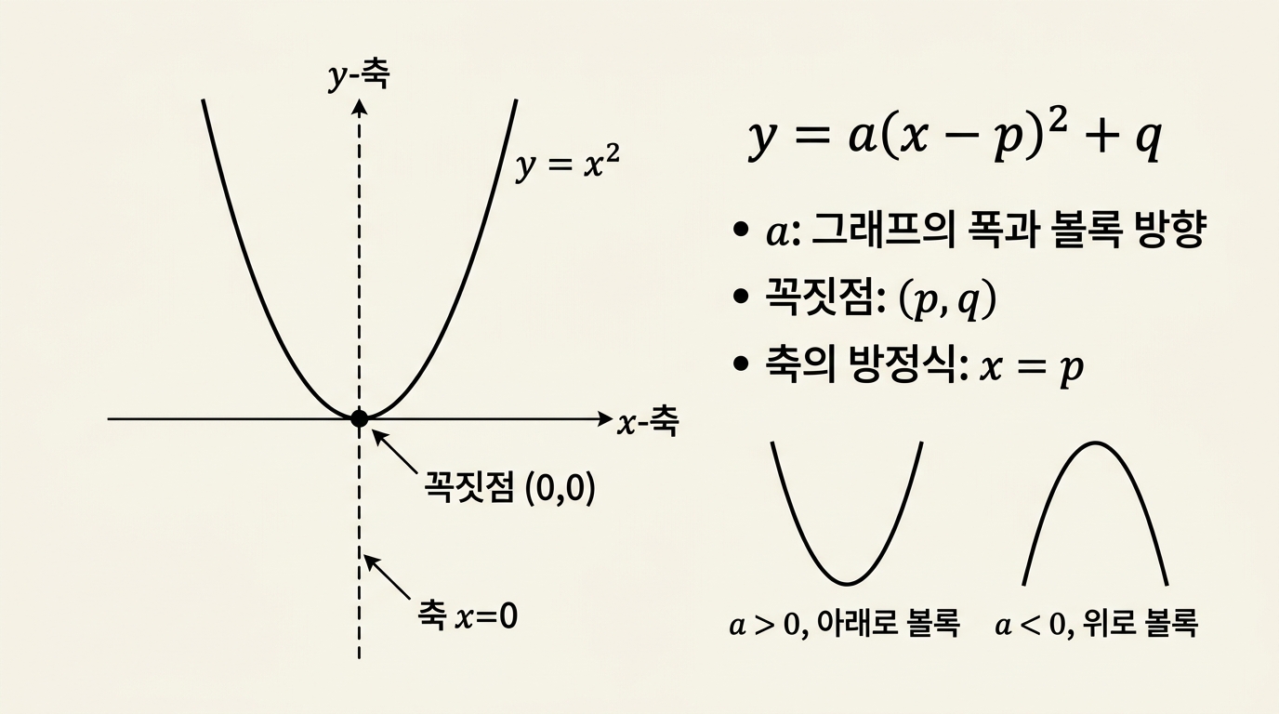
VivaMVP/viva-merged/tools/concept-images/img/quadratic-function.png
