leeyunseokarchive/VIVA-Hardware-Enabled-AI-Tutor/VivaMVP/viva-merged/tools/concept-images/img/rational-number.png

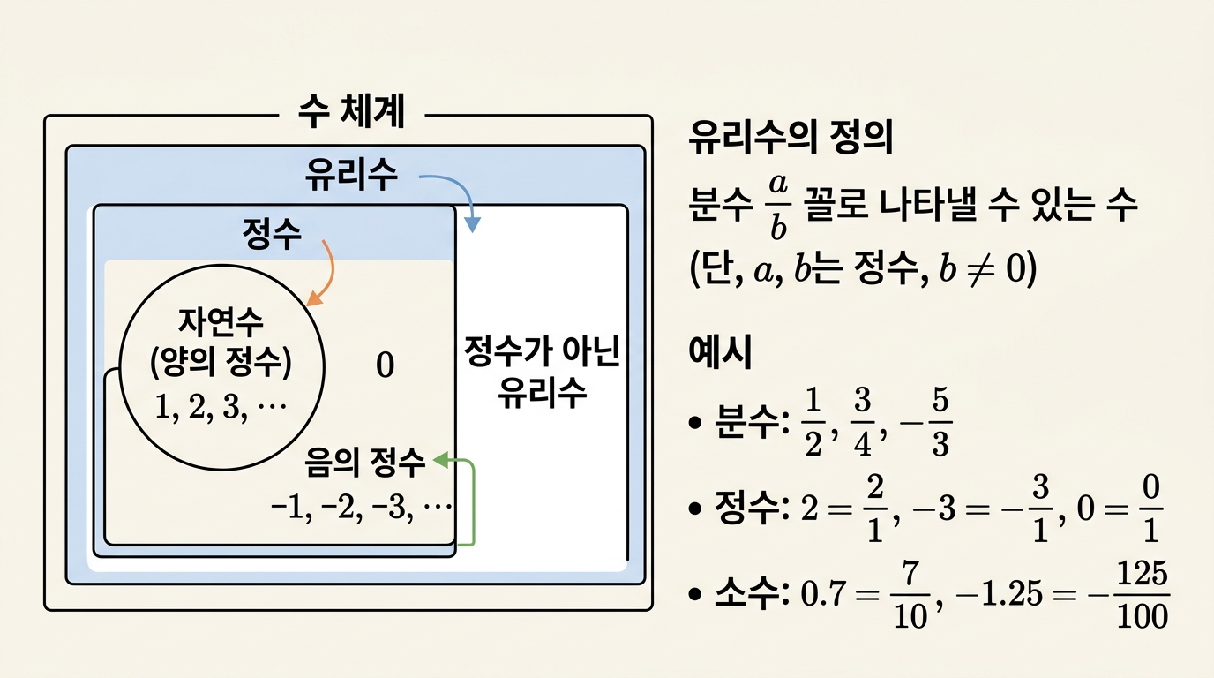
VivaMVP/viva-merged/tools/concept-images/img/rational-number.png
