leeyunseokarchive/VIVA-Hardware-Enabled-AI-Tutor/VivaMVP/viva-merged/tools/concept-images/img/repeating-decimal.png

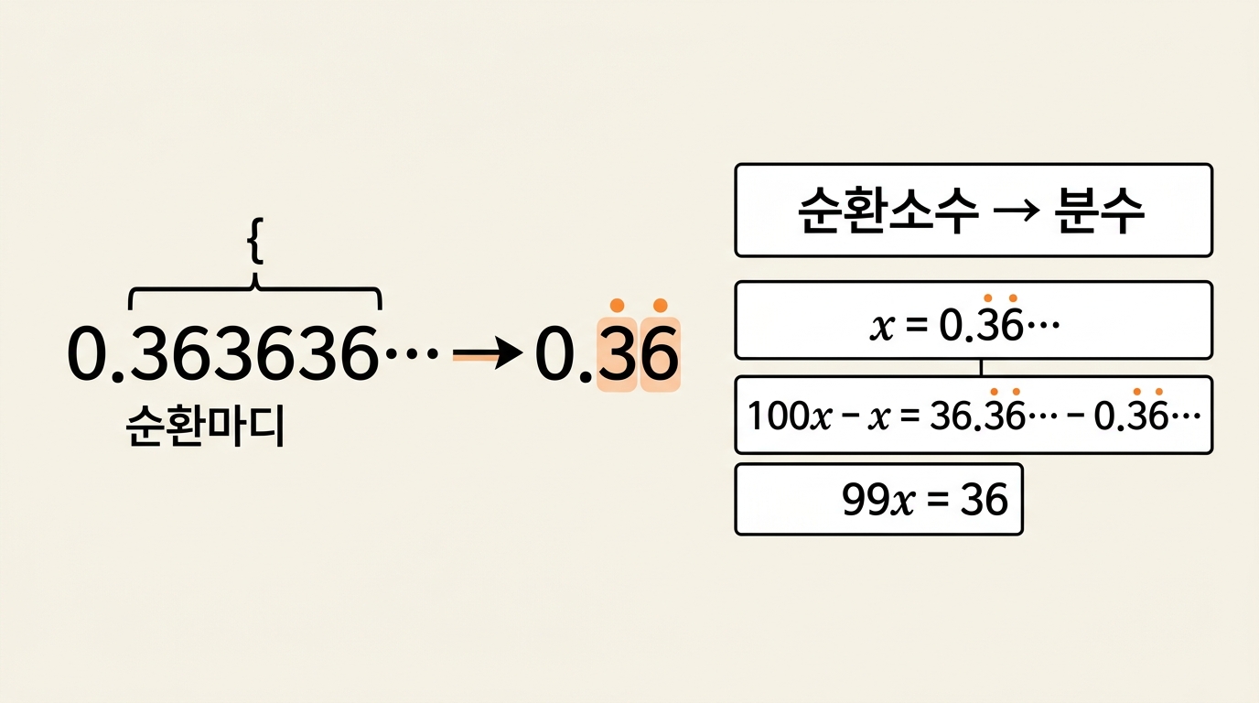
VivaMVP/viva-merged/tools/concept-images/img/repeating-decimal.png
