leeyunseokarchive/VIVA-Hardware-Enabled-AI-Tutor/VivaMVP/viva-merged/tools/concept-images/img/square-root.png

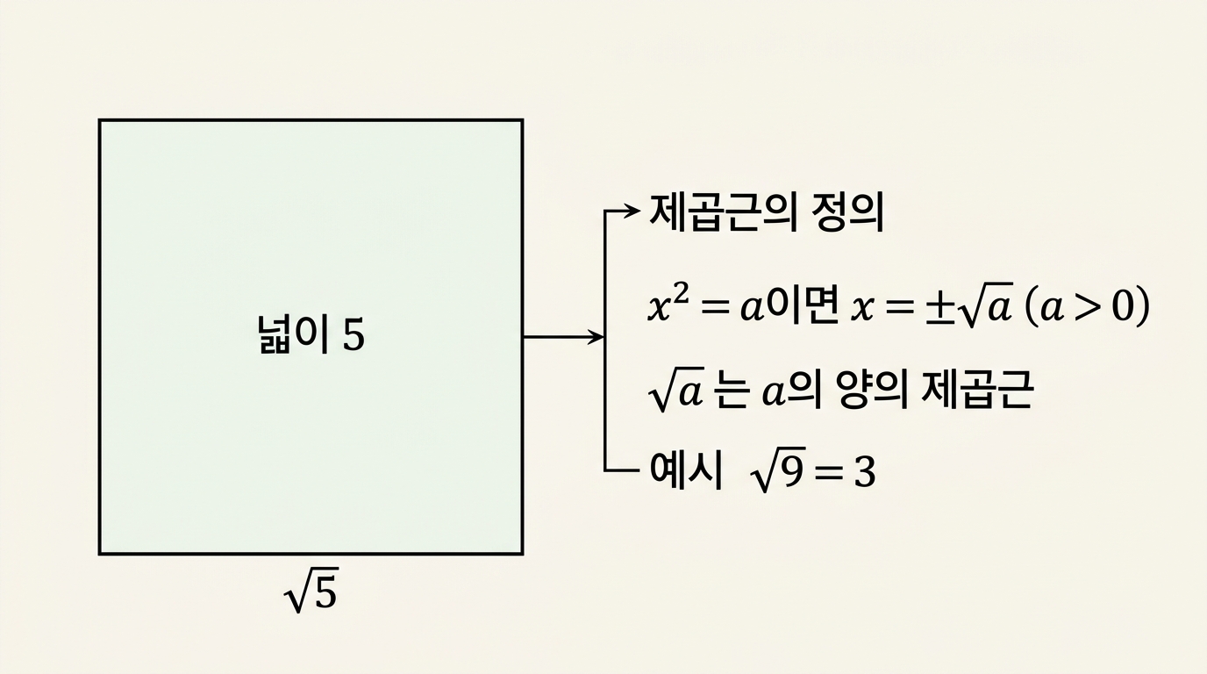
VivaMVP/viva-merged/tools/concept-images/img/square-root.png
