leeyunseokarchive/VIVA-Hardware-Enabled-AI-Tutor/VivaMVP/viva-merged/tools/concept-images/img/statistics-center.png

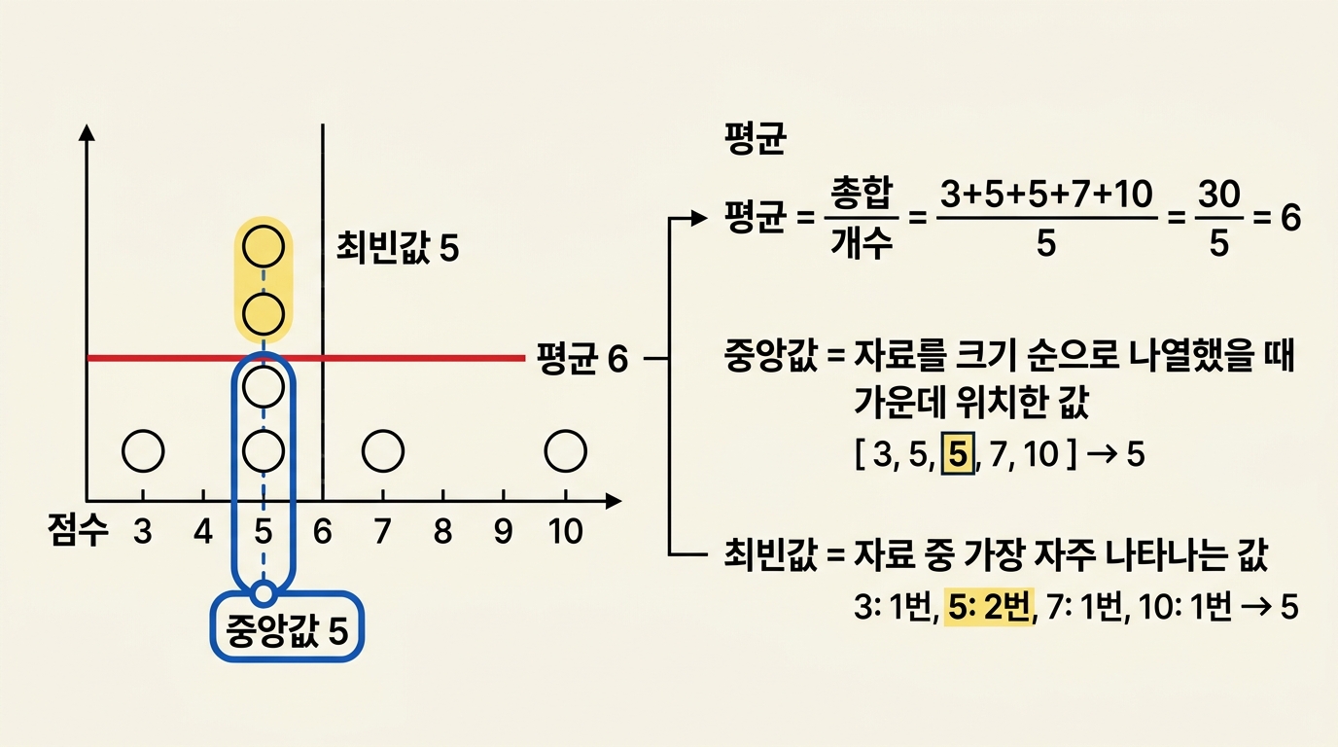
VivaMVP/viva-merged/tools/concept-images/img/statistics-center.png
