leeyunseokarchive/VIVA-Hardware-Enabled-AI-Tutor/VivaMVP/viva-merged/tools/concept-images/img/system-of-equations.png

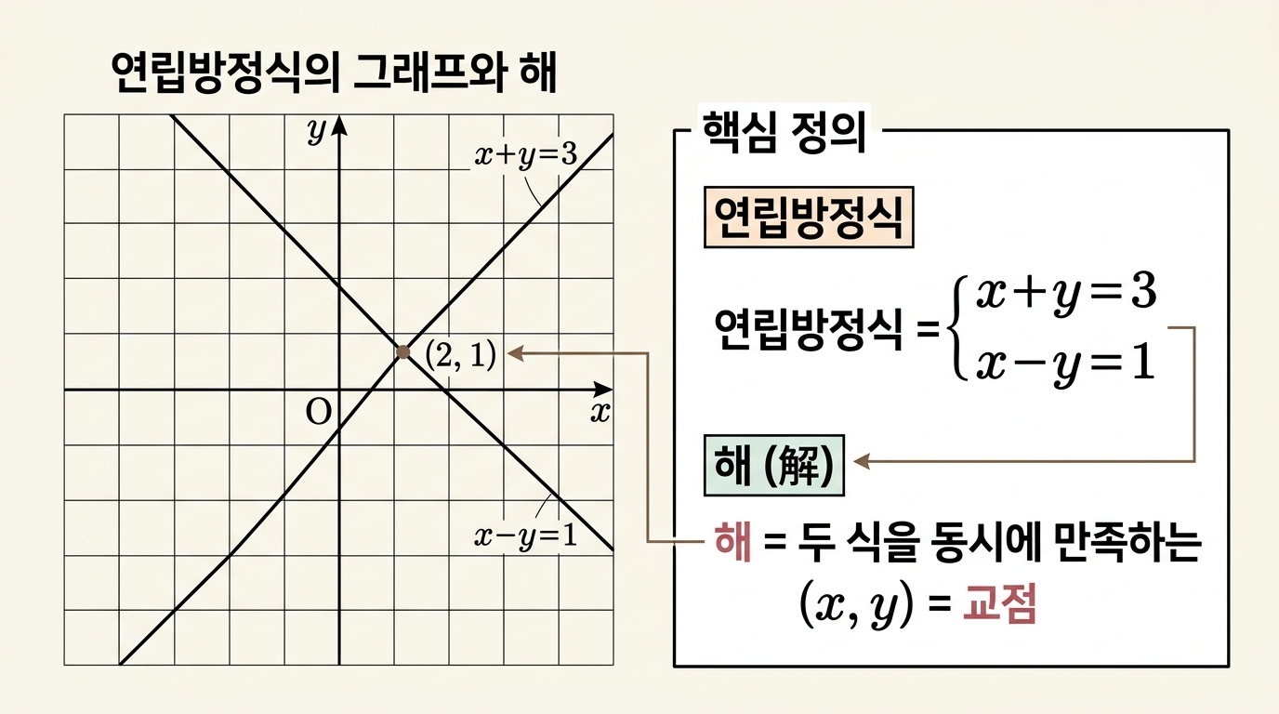
VivaMVP/viva-merged/tools/concept-images/img/system-of-equations.png
