leeyunseokarchive/VIVA-Hardware-Enabled-AI-Tutor/VivaMVP/viva-merged/tools/concept-images/img/triangle-congruence.png

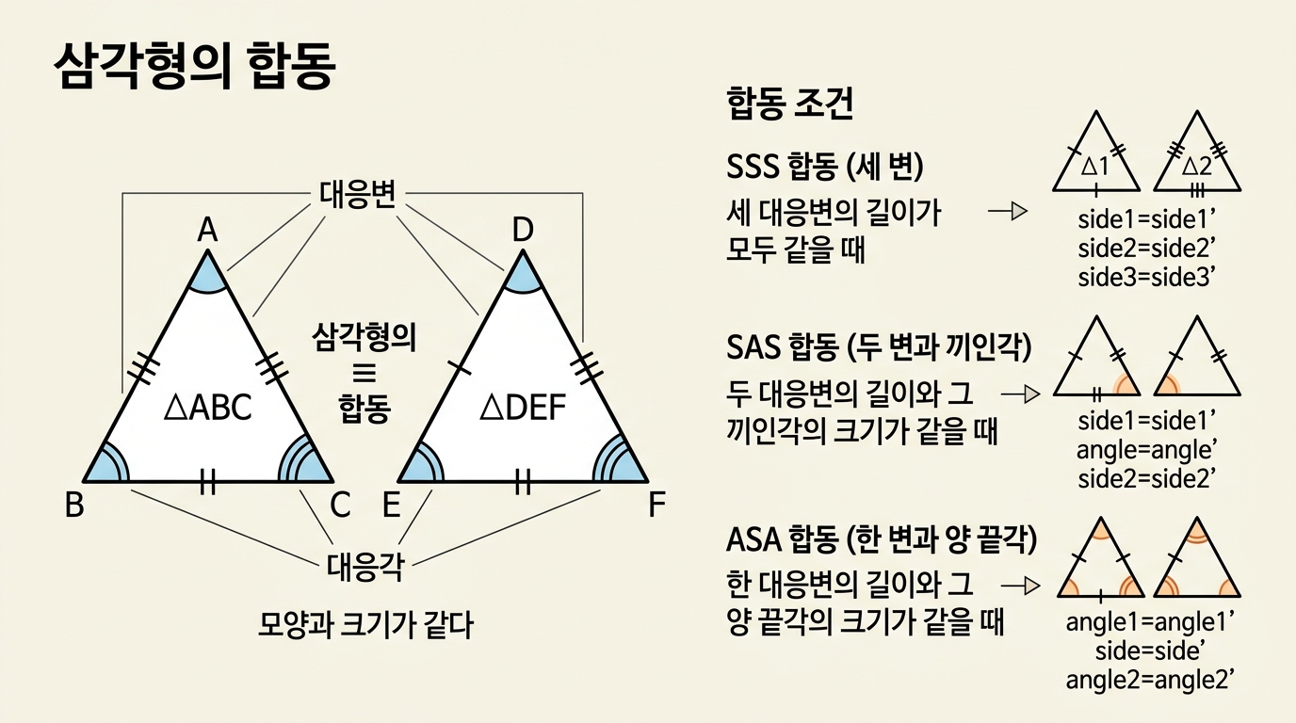
VivaMVP/viva-merged/tools/concept-images/img/triangle-congruence.png
