leeyunseokarchive/VIVA-Hardware-Enabled-AI-Tutor/VivaMVP/viva-merged/tools/concept-images/img/triangle-similarity.png

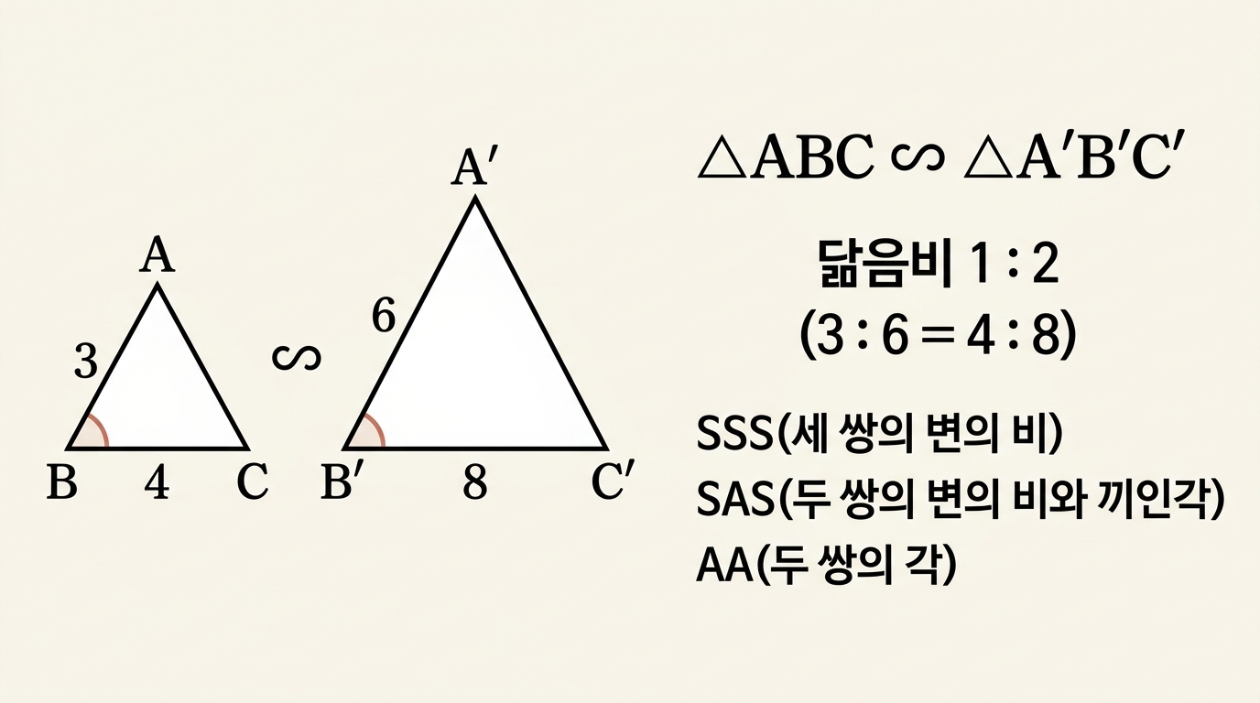
VivaMVP/viva-merged/tools/concept-images/img/triangle-similarity.png
