leeyunseokarchive/VIVA-Hardware-Enabled-AI-Tutor/VivaMVP/viva-merged/tools/concept-images/img/trigonometric-ratio.png

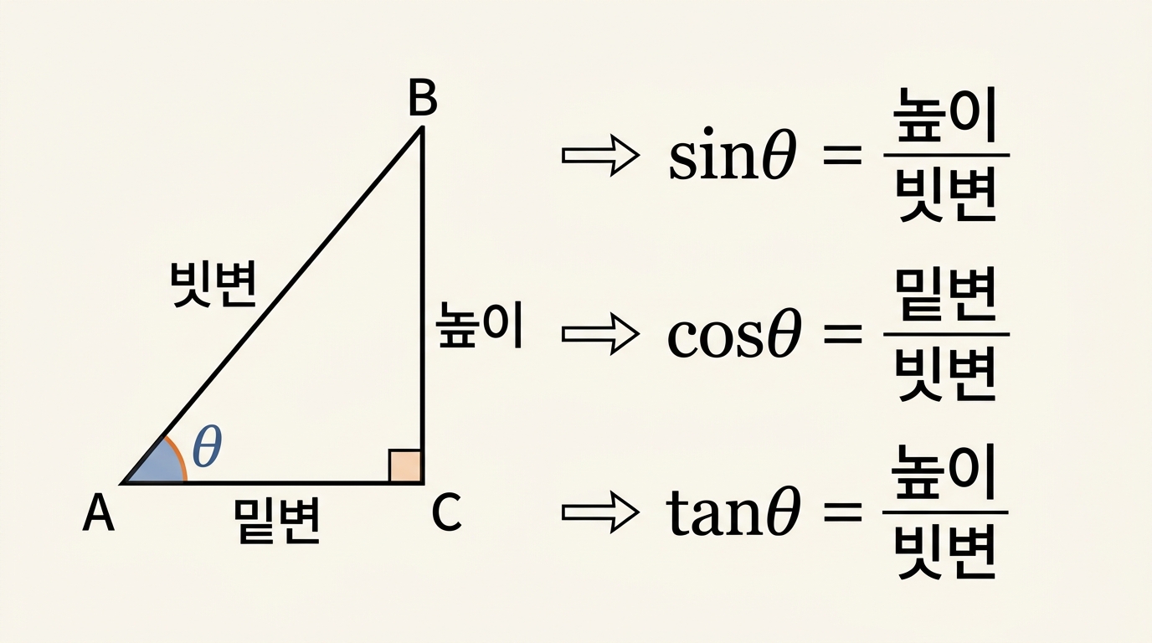
VivaMVP/viva-merged/tools/concept-images/img/trigonometric-ratio.png
