leeyunseokarchive/VIVA-Hardware-Enabled-AI-Tutor/VivaHW/models/stl/VivaHW_print_v24_front.stl

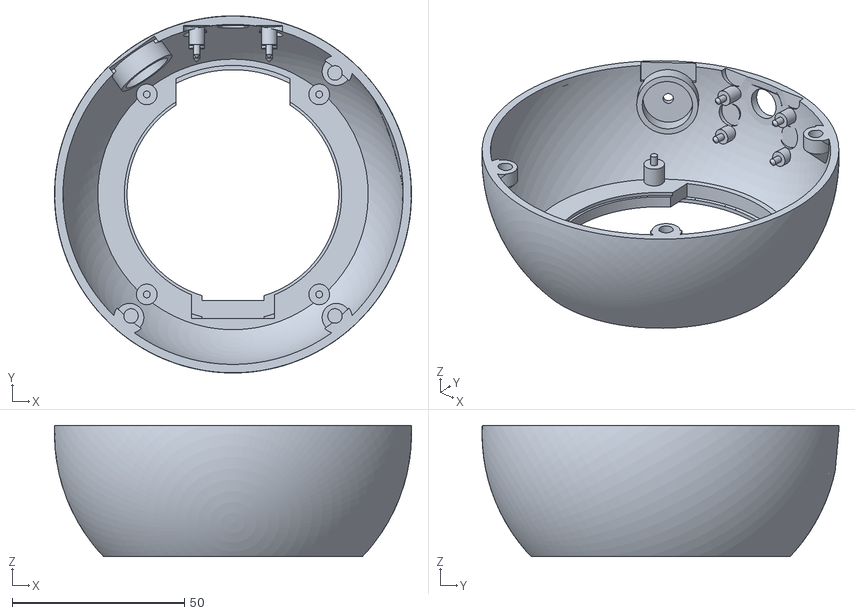
[picture p21: CAD file, 2026-09-02]
VivaHW/models/stl/VivaHW_print_v24_front.stl
103.6 x 103.5 x 38.0
