leeyunseokarchive/VIVA-Hardware-Enabled-AI-Tutor/VivaHW/models/stl/VivaHW_print_v24_back.stl

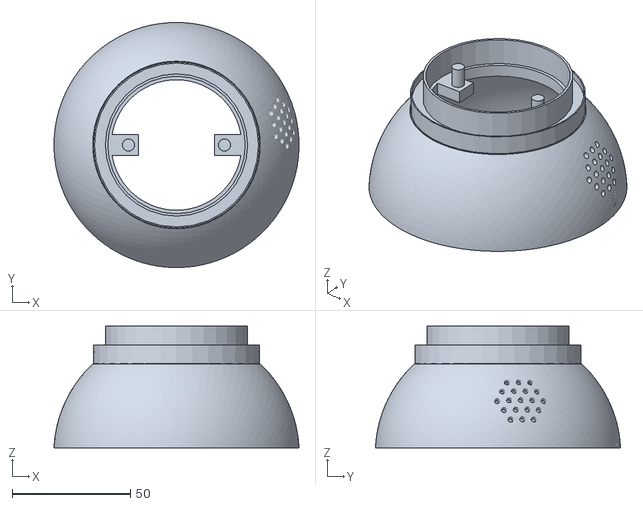
[picture p22: CAD file, 2026-09-02]
VivaHW/models/stl/VivaHW_print_v24_back.stl
103.4 x 103.4 x 51.4
