leeyunseokarchive/VIVA-Hardware-Enabled-AI-Tutor/VivaHW/models/stl/VivaHW_print_v24_pins.stl

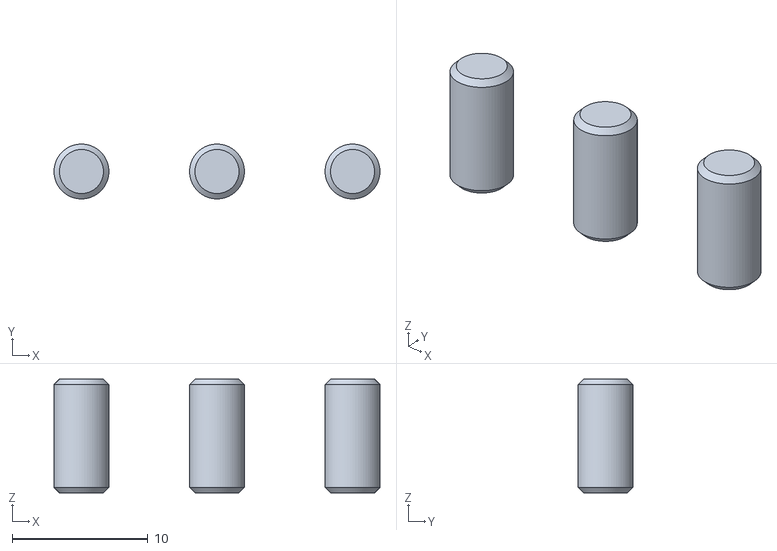
[picture p23: CAD file, 2026-09-02]
VivaHW/models/stl/VivaHW_print_v24_pins.stl
24.0 x 4.05 x 8.40
