leeyunseokarchive/VIVA-Hardware-Enabled-AI-Tutor/VivaHW/models/stl/VivaHW_print_v24_tray.stl

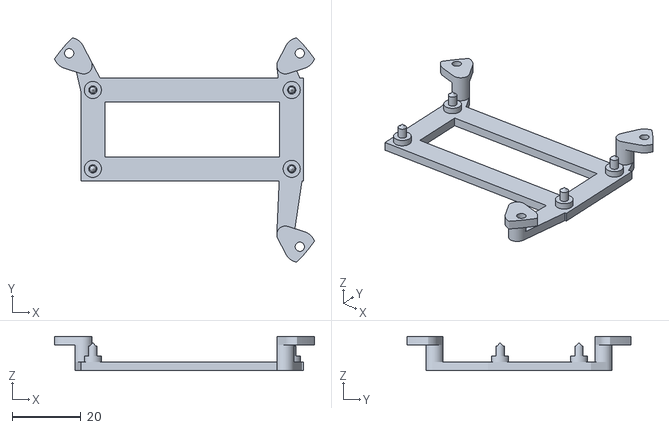
[picture p24: CAD file, 2026-09-02]
VivaHW/models/stl/VivaHW_print_v24_tray.stl
75.8 x 65.5 x 10.0
