leeyunseokarchive/VIVA-Hardware-Enabled-AI-Tutor/VivaHW/models/stl/VivaHW_print_v24_oneplate.stl

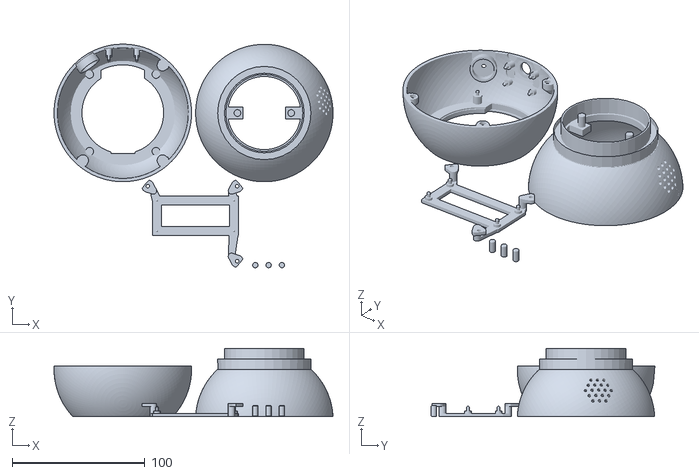
[picture p25: CAD file, 2026-09-02]
VivaHW/models/stl/VivaHW_print_v24_oneplate.stl
210.0 x 168.3 x 51.4
