leeyunseokarchive/VIVA-Hardware-Enabled-AI-Tutor/(list of files, cad)

Other CAD files:
VivaHW/models/stl/VivaHW_print_v23_oneplate.stl
VivaHW/models/stl/VivaHW_print_v23_back.stl
VivaHW/models/stl/VivaHW_print_v23_front.stl
VivaHW/models/stl/VivaHW_print_v23_tray.stl
VivaHW/models/blender/VivaHW_head_LR.blend
VivaHW/models/blender/gearbox.blend
VivaHW/models/blender/joint.blend
