leeyunseokarchive/VIVA-Hardware-Enabled-AI-Tutor/(commit log)

2026-09-02 Initial commit: VIVA portfolio snapshot (hardware + software, sanitized)
    Curated public snapshot of the VIVA AI math tutor robot project.
    - VivaHW: robot head hardware design (3D models, wiring, assembly)
    - VivaMVP: React Native app + Raspberry Pi server
    - CI: lint + typecheck + jest via GitHub Actions
    - Removed: internal business/finance docs, legacy archive, team
    comparison repos, and API keys (rotated placeholders in .env.example)
    [VivaHW_head_LR.blend, VivaHW_print_v23_back.stl, VivaHW_print_v23_front.stl, VivaHW_print_v23_oneplate.stl, VivaHW_print_v23_pins.stl, VivaHW_print_v23_tray.stl, VivaHW_print_v24_back.stl, VivaHW_print_v24_front.stl]
2026-09-02 ci: use --forceExit for jest to avoid leaked-timer exit code flake
