leeyunseokarchive/VIVA-Hardware-Enabled-AI-Tutor/(notices)

Notices in the files:
README.md:
License: MIT
